Yexall/CPE-450.Capstone/README.md

# CPE-450.Capstone
Authors:
- Cameron Bracken
- Ryan Jacoby
- Noa Johnson
- Yexelle Nash Segovia
