Yexall/CPE-450.Capstone/Hardware/README.md

# Haas Hooligans Hardware

Board assembly prints and schematics for the final prototypes are provided in this directory. The three folders (IIS3DWB\_eval, IIS3DWB\_breakout\_beta, and hw\_alpha) have more detailed design sources for each of the PCBs designed.

## Main Board
Bringup notes and notes for the next revision of the main board can be found [here](https://github.com/Yexall/CPE-450.Capstone/blob/main/Hardware/hw_alpha/bringup_notes.md)

An interactive HTML BOM can be found [here](https://html-preview.github.io/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)

A downloadable PDF assembly document can be found [here](https://github.com/Yexall/CPE-450.Capstone/blob/main/Hardware/hw_alpha/plots/hw_alpha__Assembly.pdf)

A downloadable PDF schematic can be found [here](https://github.com/Yexall/CPE-450.Capstone/blob/main/Hardware/hw_alpha/hw_alpha_schem.pdf)

## IIS3DWB Breakout
A downloadable PDF assembly document can be found [here](https://github.com/Yexall/CPE-450.Capstone/blob/main/Hardware/IIS3DWB_breakout_beta/plots/IIS3DWB_breakout_beta__Assembly.pdf)

A downloadable PDF schematic can be found [here](https://github.com/Yexall/CPE-450.Capstone/blob/main/Hardware/IIS3DWB_breakout_beta/IIS3DWB_breakout_beta_schem.pdf)

## Copyright
Copyright Ryan Jacoby, Cal Poly CPE Department, Cal Poly IME Department 2025.

This source describes Open Hardware and is licensed under the CERN-OHL-P v2

You may redistribute and modify this documentation and make products
using it under the terms of the CERN-OHL-P v2 (https:/cern.ch/cern-ohl).
This documentation is distributed WITHOUT ANY EXPRESS OR IMPLIED
WARRANTY, INCLUDING OF MERCHANTABILITY, SATISFACTORY QUALITY
AND FITNESS FOR A PARTICULAR PURPOSE. Please see the CERN-OHL-P v2
for applicable conditions
