Yexall/CPE-450.Capstone/final_poster.pdf

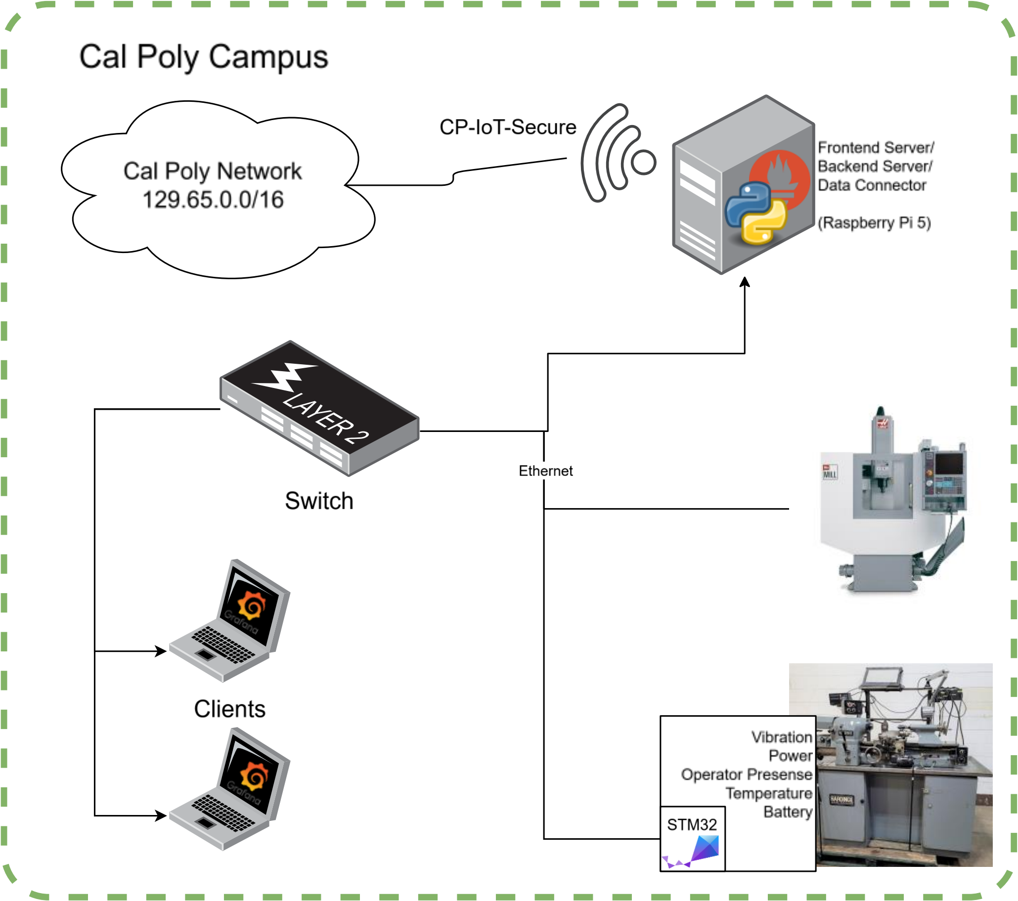
[picture p1: figure]
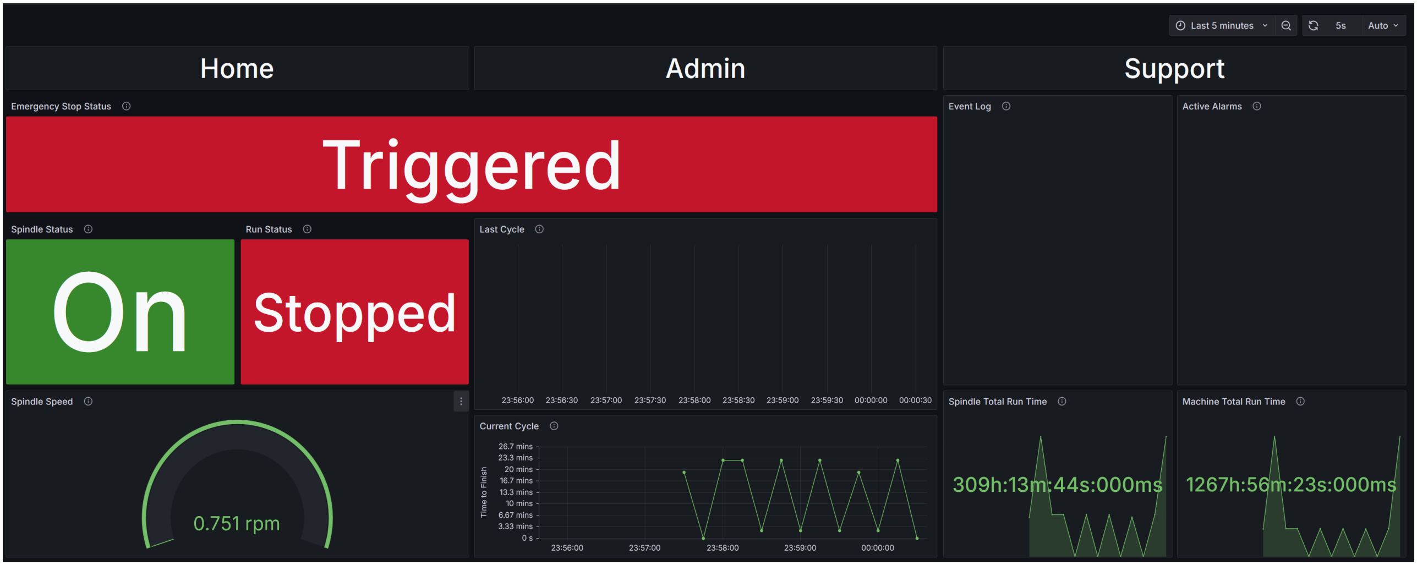
[picture p2: figure]

Power
Power can be provided through Ethernet (PoE), or USB-C through wall adapter or battery. The higher voltage supply will be voted through a PFET high-side switch to power 3.3 V regulator.
Sensing
The hardware includes vibration and temperature sensing using the IIS3DWB MEMS vibration sensor, held on a breakout board below the main PCB. Operator presence sensing can be done using a pre-made LD2401C breakout board. Connectivity
The hardware networks over Ethernet, WiFi, and could also log data over USB. An SD card is provided for offline logging. Older CNC machines can interface through the RS-232 port on the hardware. Further custom sensor boards to measure ways temperature, power consumption, or other metrics can easily be added through the two I2C expansion ports.

Sensor
Sensor data is collected via the STM32 running Zephyr RTOS over SPI from the II3WDWB sensor and currently outputting to the onboard UART terminal.

Dashboard
The dashboard collects data from the Haas machines and stores it in the Prometheus data base and visualized on the Grafana dashboard.

Purpose
The primary purpose of our project is to establish a robust, permanent digital infrastructure within the IME lab that enables real-time monitoring of machine tools. This infrastructure is designed to enhance operational efficiency, improve safety, and support proactive maintenance by providing instantaneous access to critical performance data.

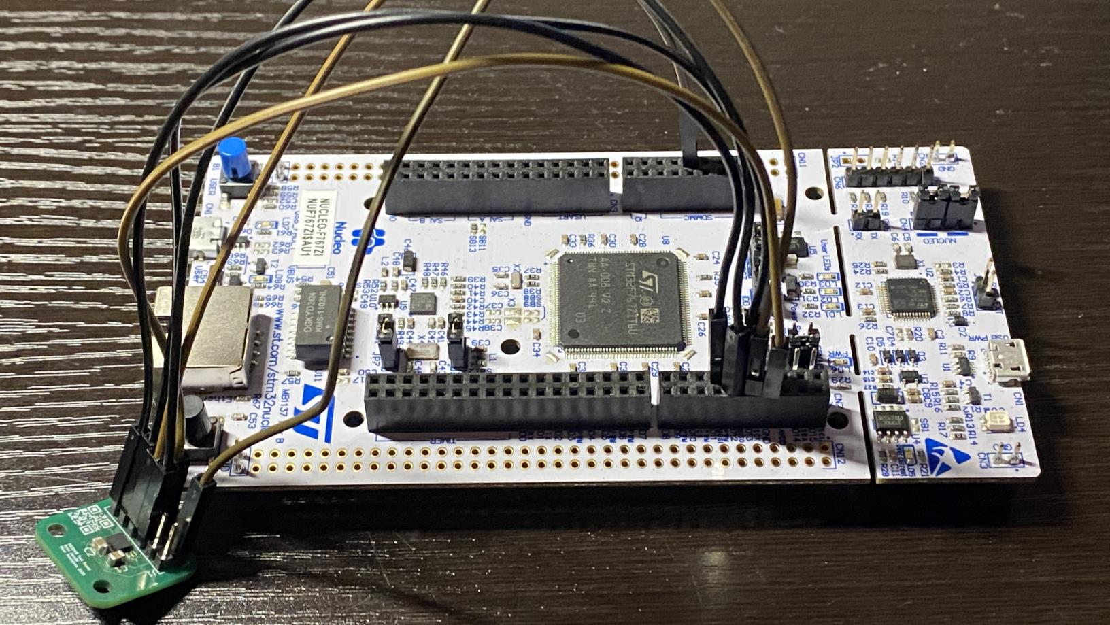
[picture p3: figure]
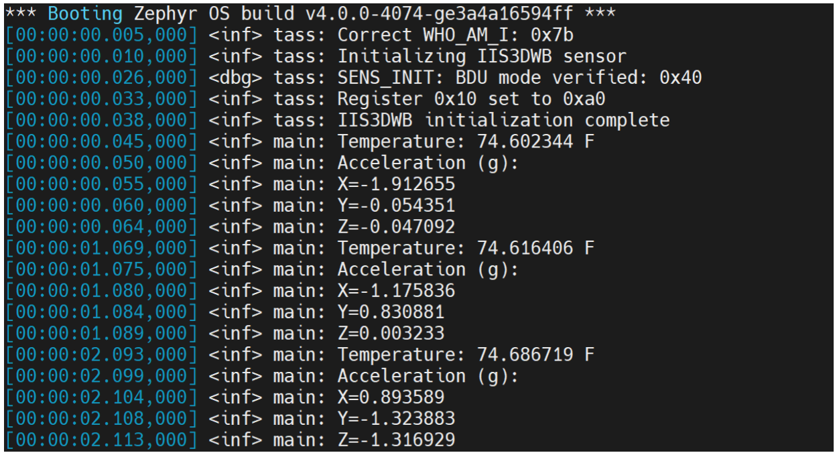
[picture p4: figure]

Objectives
- Sensor Integration
- Data Transmission & Processing
- User Interface Development
- Scalability & Future-proofing

## Project Overview

# MACHINE MONITORING IN THE IME LAB

COMPUTER ENGINEERING CAPSTONE 2025

## Requirements

Value to Customer | Description
Enable real-time monitoring of machine status and performance metrics | Remotely accessible, graphical representation of lab room
Infrastructure is thoroughly documented and designed for long-term sustainability | Develop an infrastructure plan to ensure long-term maintainability of the project
Provide enhanced visibility in non-networked, older machines | Custom hardware devices for capturing and transmitting sensor data
New machines are added to the infrastructure as they are acquired | Easily expandable to new hardware

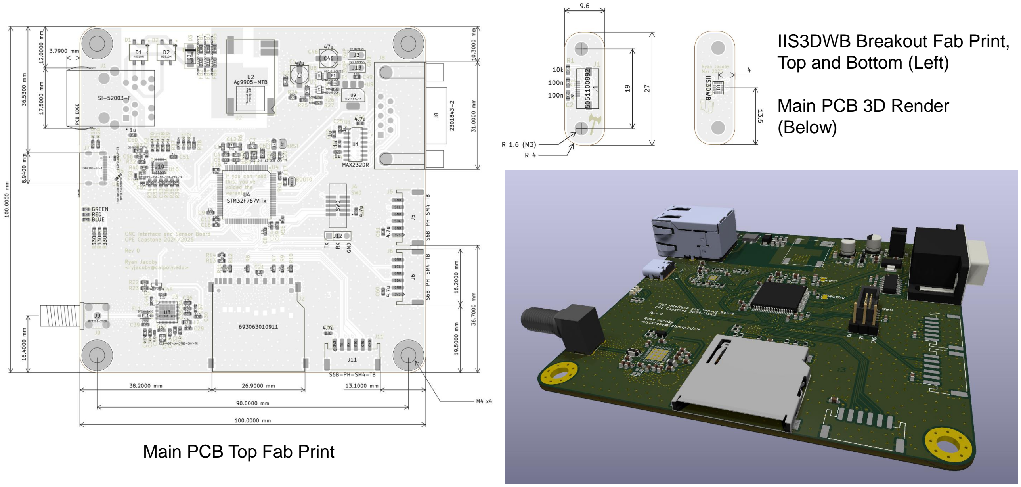
[picture p5: figure]
Main PCB Top Fab Print; IIS3DWB Breakout Fab Print, Top and Bottom (Left); Main PCB 3D Render (Below)

## Project/Product Results

## Demonstrated innovative, hands-on solutions to real-world

challenges at Cal Poly San Luis Obispo.

## Team

## Ryan Jacoby Nash Segovia Cameron Bracken Noa Johnson

## Client

## Dan Waldorf

Cal Poly IME Dept.

## Hardware Design

## System Architecture

## Sensor-to-Dashboard Integration

## Verification Plans

Specification | Description
Data Collection Timing | Run firmware under simulated operational conditions. Log sampling intervals and compare against nominal values.
Error Handling | Inject various error conditions and monitor the firmware’s logging and exception handling mechanisms.
Data Visualization | Query large quantities of data. Check for freeing or outdated information.
Concurrent Users | Have multiple users access the website at the same time. Monitor the performance and stability during heavy loads.

## Learnings and Future Work

Learnings:
- Researching of certain systems during firmware development took a long time
- During PCB design research of standards and components was a significant time strain.
Future Work:
- Testing of firmware and hardware integration
- Testing of firmware and Grafana/Prometheus integration
