Yexall/CPE-450.Capstone/Hardware/hw_alpha/stm32_pinout.png

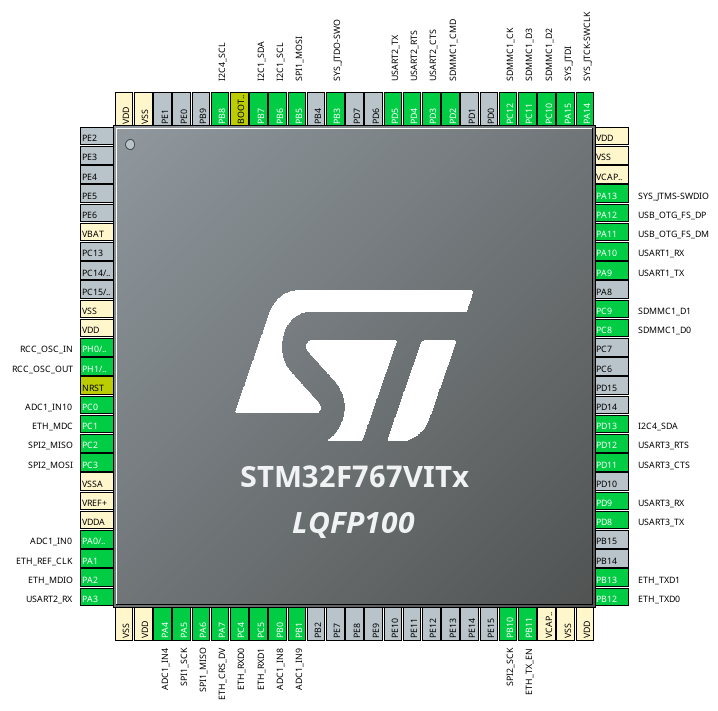
Hardware/hw_alpha/stm32_pinout.png
