Yexall/CPE-450.Capstone/Hardware/hw_alpha/3D/Wurth-693063010911.stp

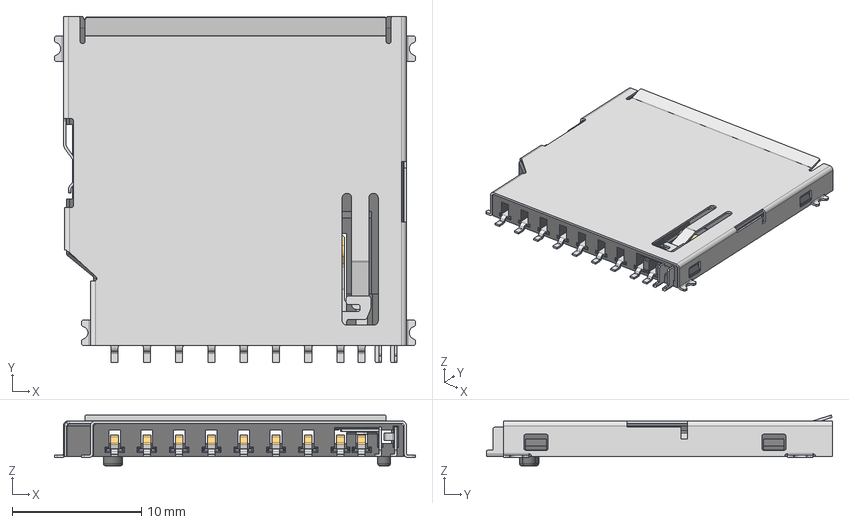
[picture p7: CAD file, 2025-03-19]
Hardware/hw_alpha/3D/Wurth-693063010911.stp
28.0 x 26.8 x 3.95 mm
693063010911_Housing
693063010911_PIN_CONTACT
693063010911_PIN_RETENTION
693063010911_PIN_P x 5
693063010911_PIN_M
693063010911_PIN_G x 2
693063010911_PIN_TG
693063010911_Shielding
