Yexall/CPE-450.Capstone/Hardware/hw_alpha/3D/USB4105-GF-A.step

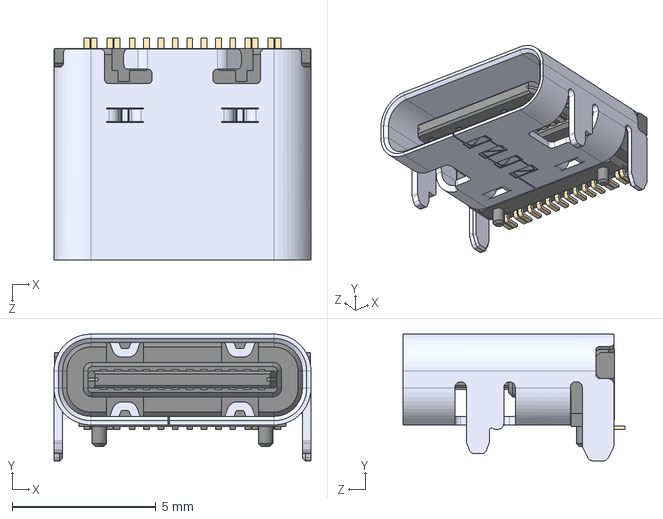
[picture p8: CAD file, 2025-03-19]
Hardware/hw_alpha/3D/USB4105-GF-A.step
8.94 x 4.41 x 7.71 mm
