Yexall/CPE-450.Capstone/Hardware/hw_alpha/3D/3220-10-0300-00.step

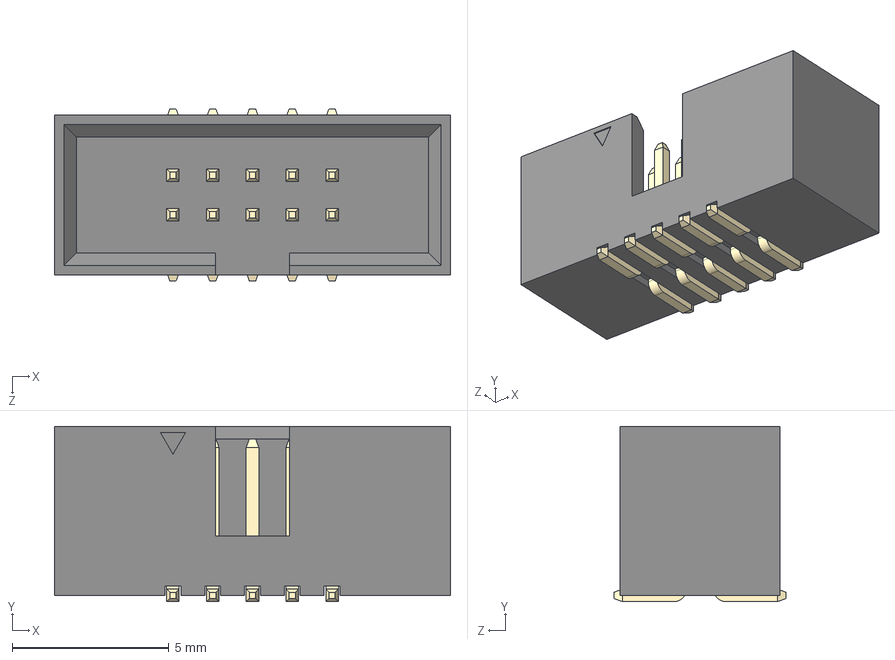
[picture p9: CAD file, 2025-03-19]
Hardware/hw_alpha/3D/3220-10-0300-00.step
12.7 x 5.60 x 5.50 mm
3220-xx-0300-00 body_10
Pin^3220-xx-0300-00 x 5
MirrorPin^3220-xx-0300-00 x 5
