Yexall/CPE-450.Capstone/Hardware/hw_alpha/3D/SI-52003-F.step

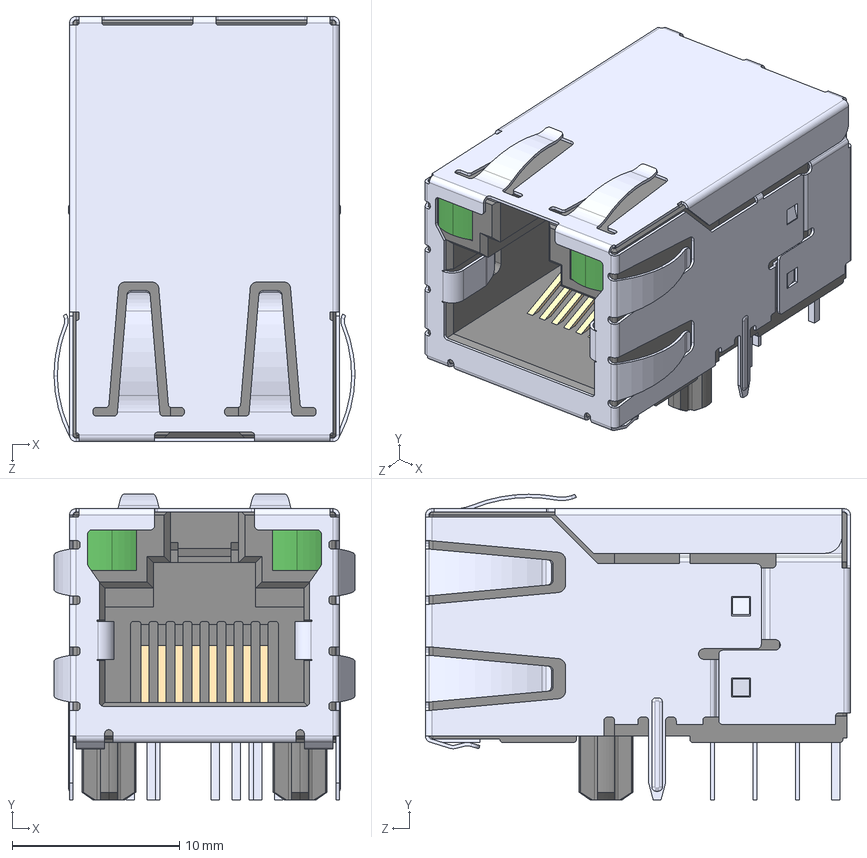
[picture p10: CAD file, 2025-03-19]
Hardware/hw_alpha/3D/SI-52003-F.step
18.0 x 18.3 x 25.4 mm
