Yexall/CPE-450.Capstone/Hardware/hw_alpha/3D/c-2301843-2-b1-3d.stp

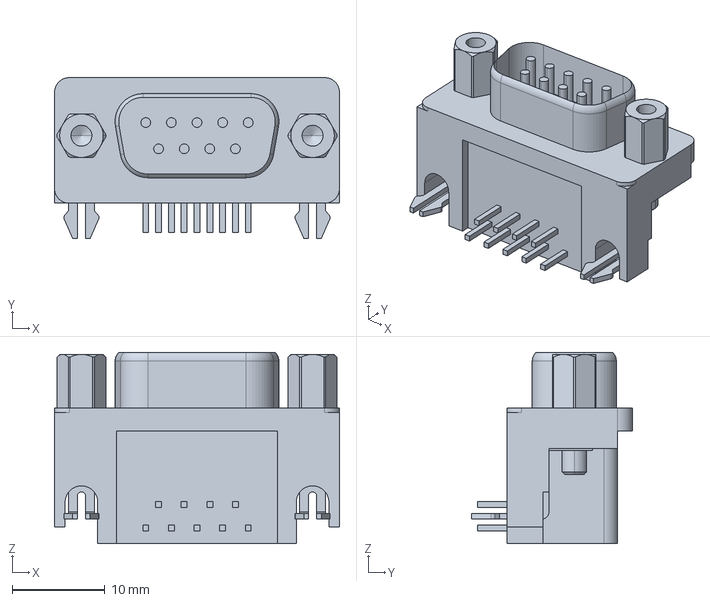
[picture p11: CAD file, 2025-03-19]
Hardware/hw_alpha/3D/c-2301843-2-b1-3d.stp
30.8 x 17.4 x 20.6 mm
