Yexall/CPE-450.Capstone/Hardware/hw_alpha/3D/HDS_DIO.step

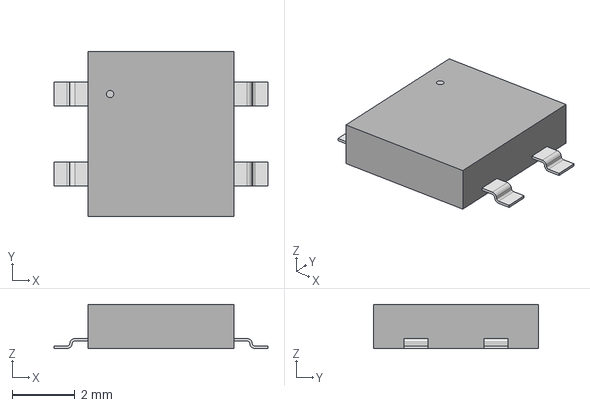
[picture p12: CAD file, 2025-03-19]
Hardware/hw_alpha/3D/HDS_DIO.step
6.81 x 5.26 x 1.40 mm
