Yexall/CPE-450.Capstone/Hardware/IIS3DWB_breakout_beta/3D/5051100892.stp

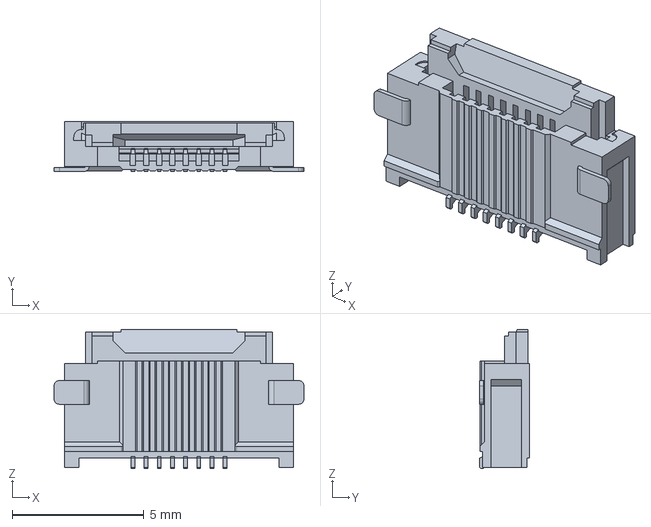
[picture p13: CAD file, 2025-03-19]
Hardware/IIS3DWB_breakout_beta/3D/5051100892.stp
9.50 x 1.90 x 5.30 mm
