Yexall/CPE-450.Capstone/Hardware/hw_alpha/hw_alpha_schem.pdf

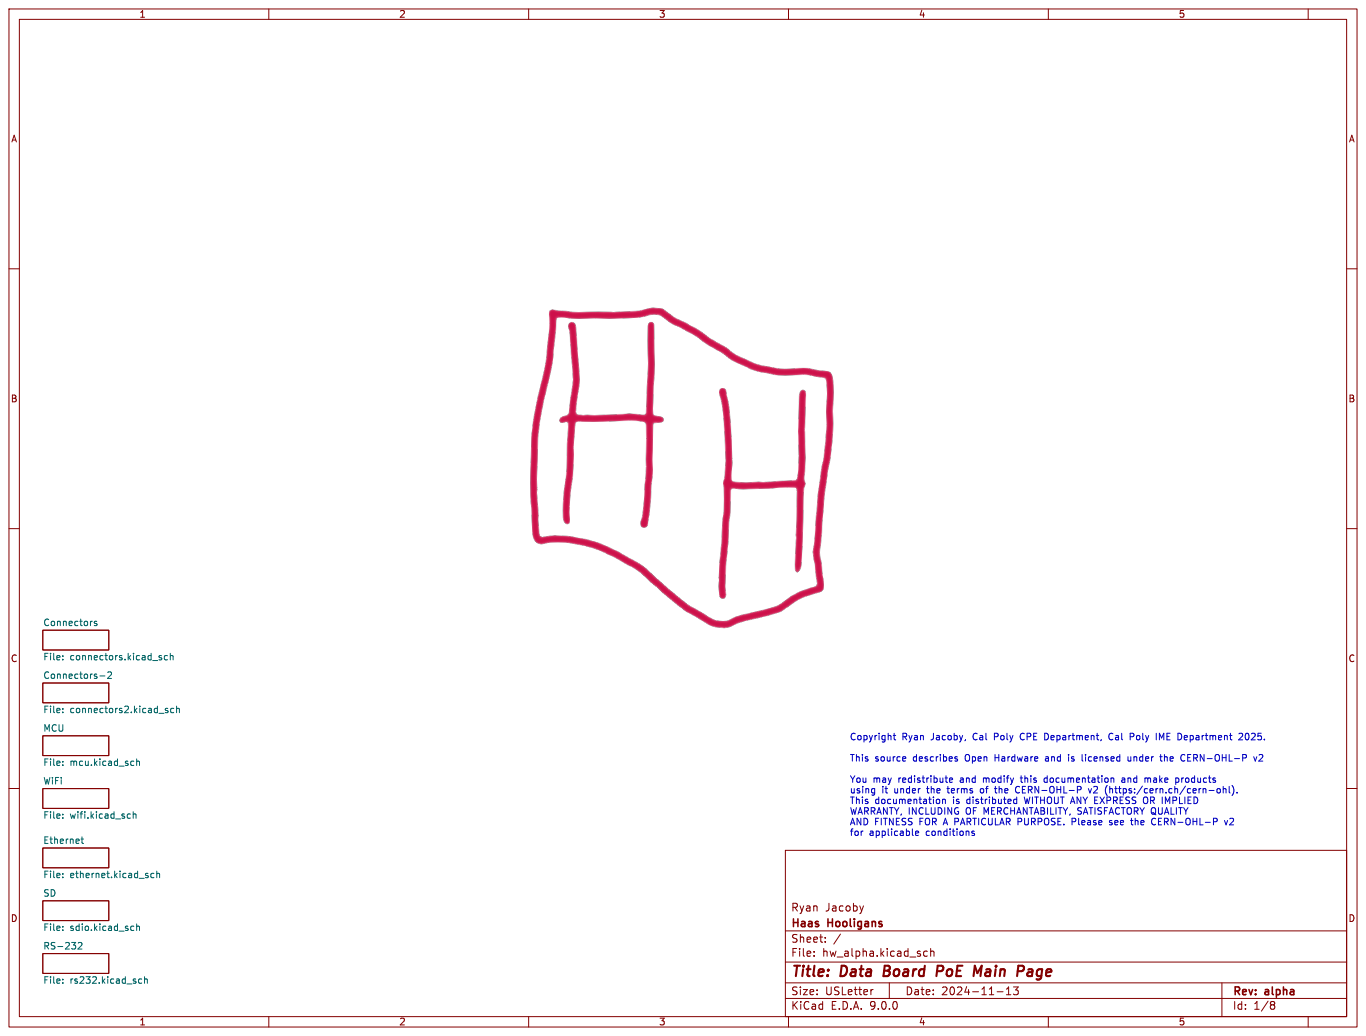
[picture p15: page 1]

Ryan Jacoby Connectors File: connectors.kicad_sch RS-232 File: rs232.kicad_sch Connectors-2 File: connectors2.kicad_sch Ethernet File: ethernet.kicad_sch SD
File: sdio.kicad_sch MCU

Id: 1/8 Title: Data Board PoE Main Page

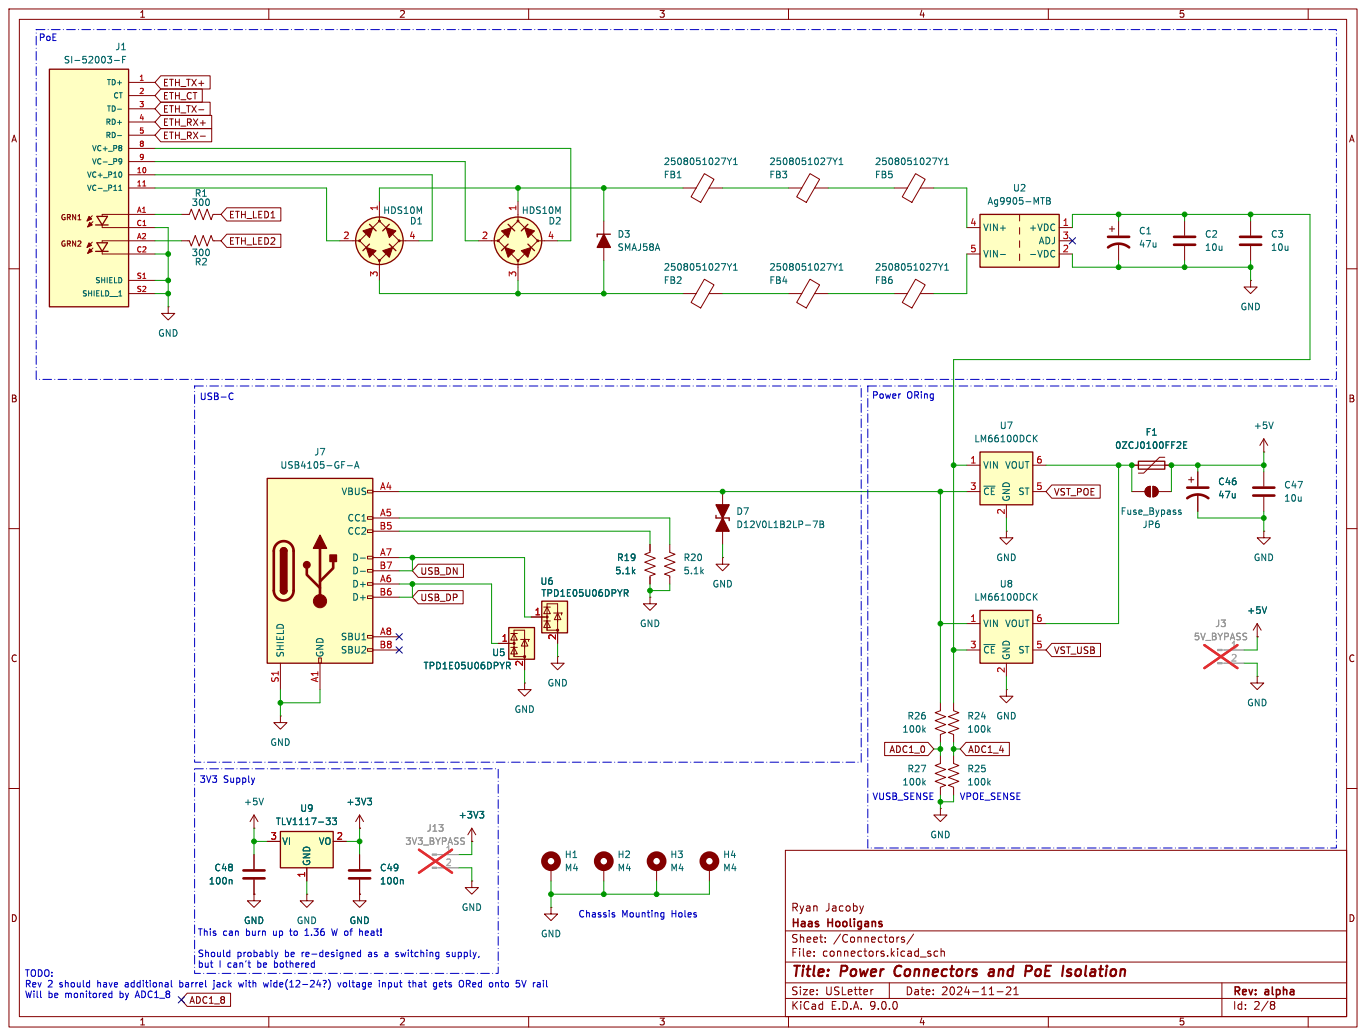
[picture p16: page 2]

Id: 2/8 Title: Power Connectors and PoE Isolation

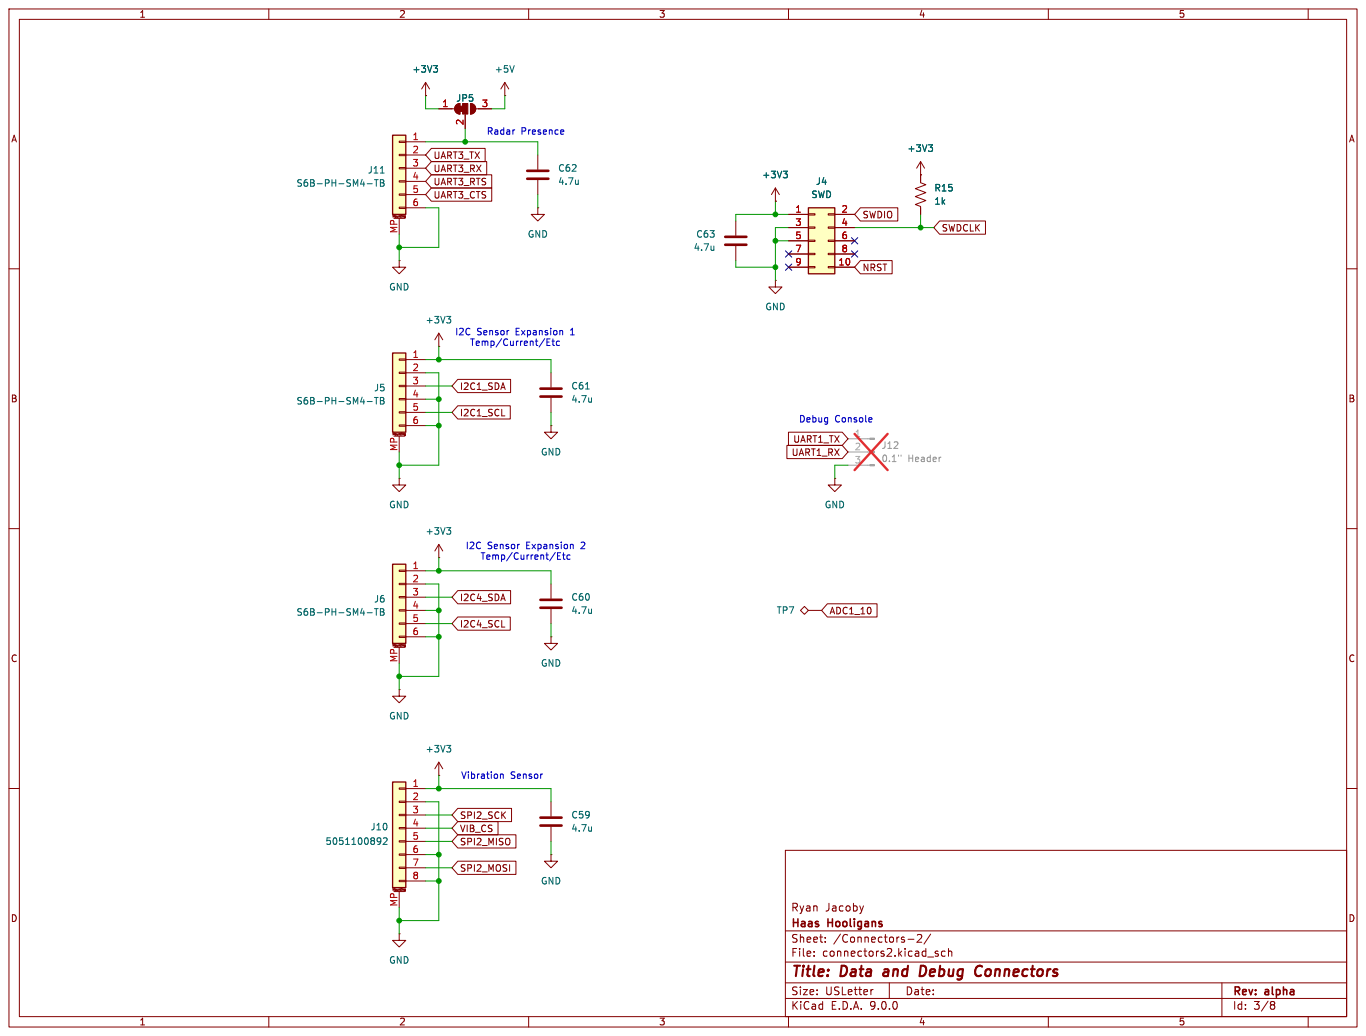
[picture p17: page 3]

I2C Sensor Expansion 1 Temp/Current/Etc
I2C1_SCL SPI2_MOSI SPI2_SCK

Id: 3/8 Title: Data and Debug Connectors

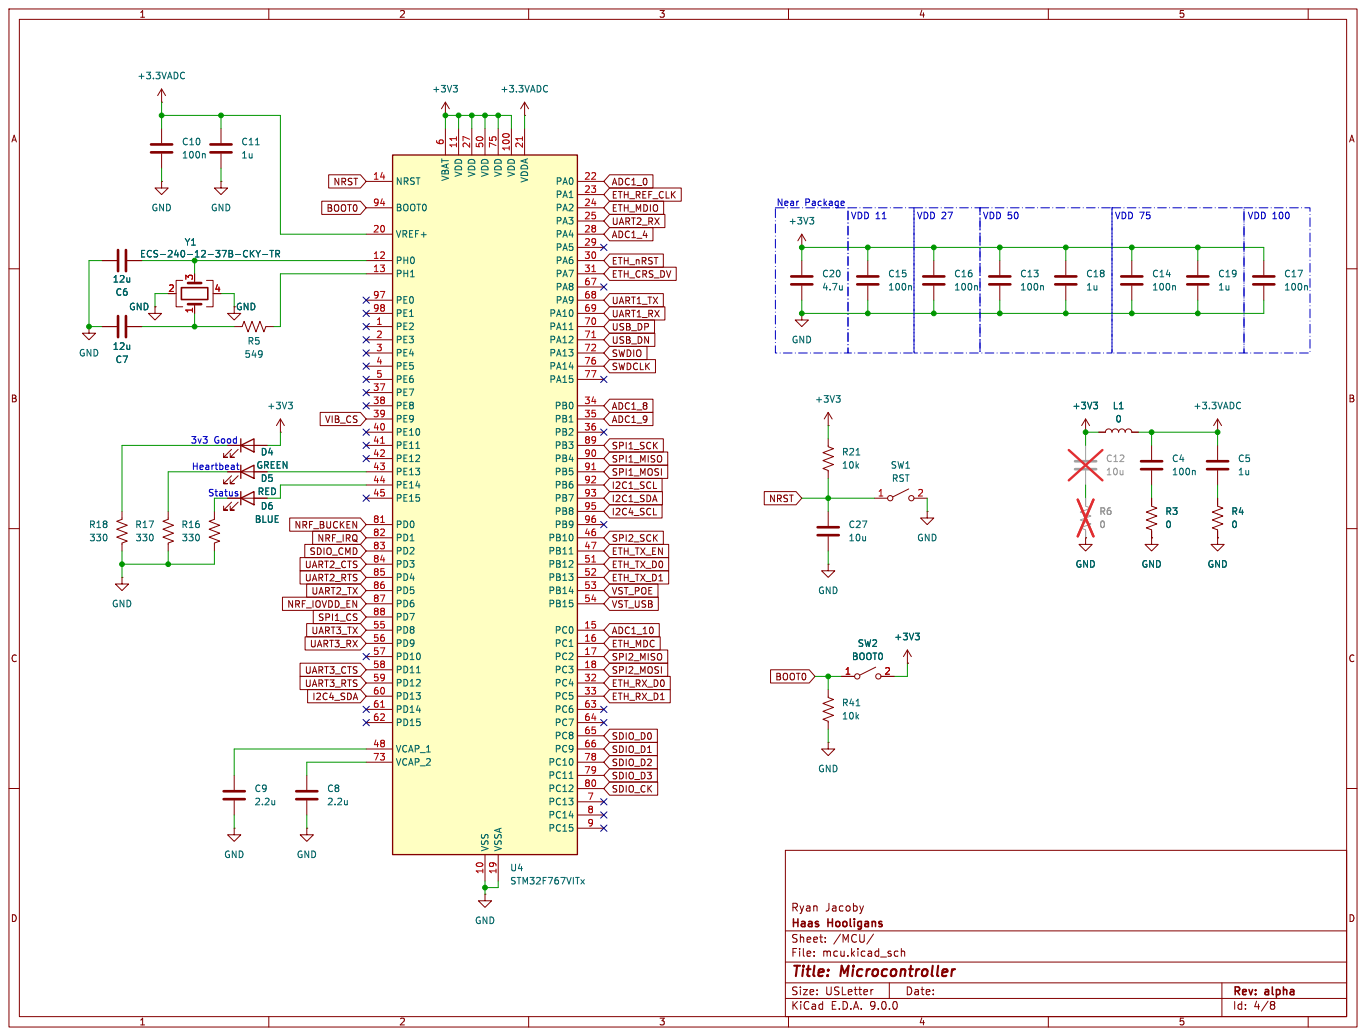
[picture p18: page 4]

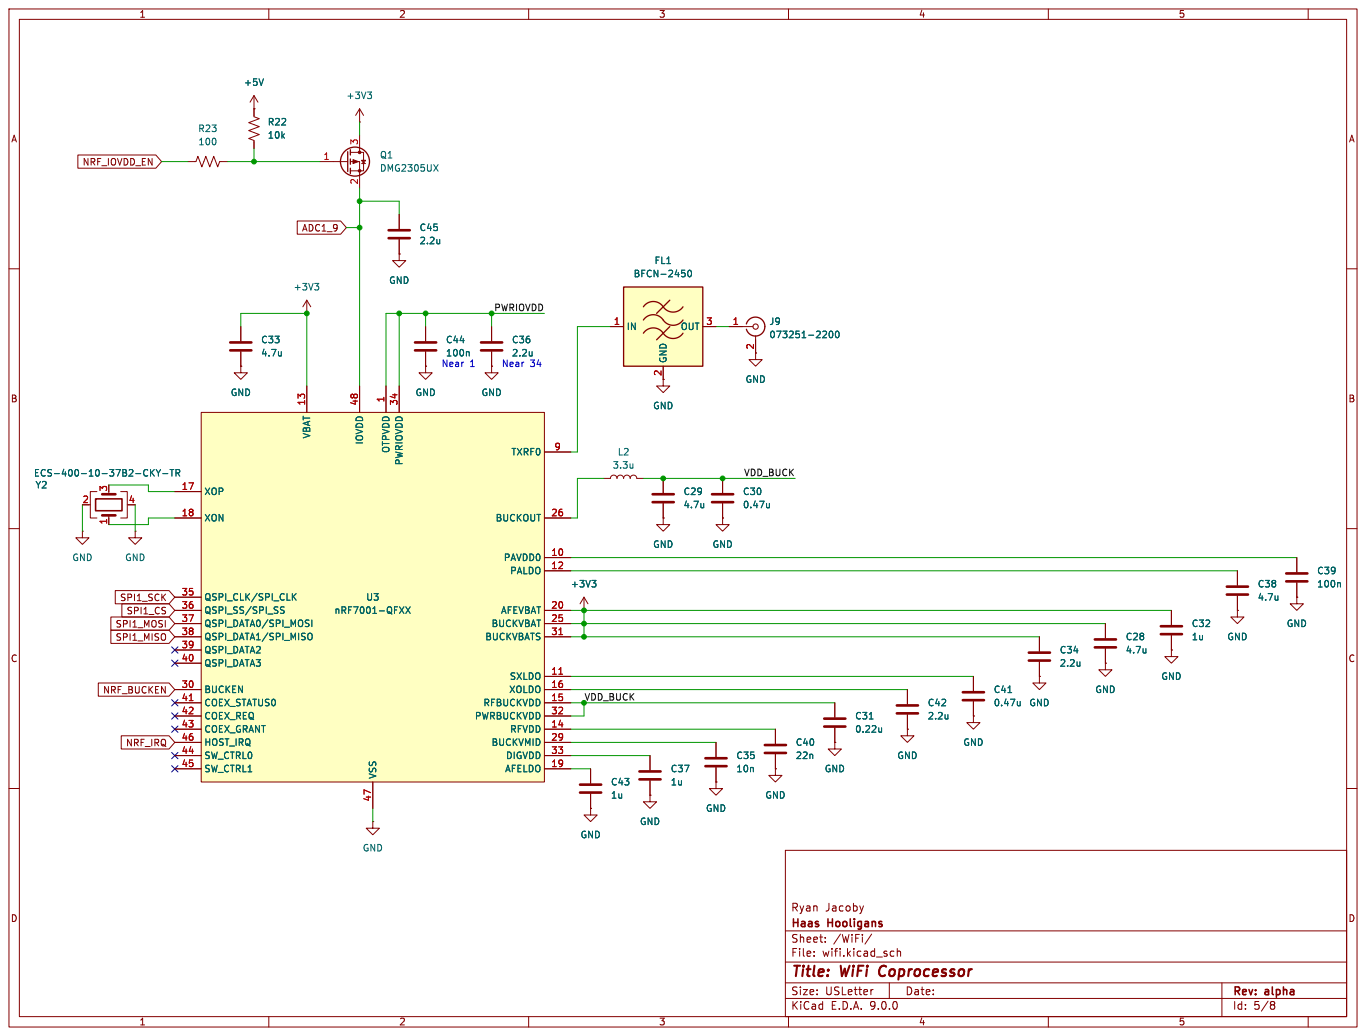
[picture p19: page 5]

1 PWRIOVDD 34 TXRF0 9 BUCKOUT 26 PAVDD0 10 PALDO 12 AFEVBAT 20 BUCKVBAT 25 BUCKVBATS 31 SXLDO 11 XOLDO 16 RFBUCKVDD 15 PWRBUCKVDD 32 RFVDD 14 BUCKVMID 29 DIGVDD 33 AFELDO 19 QSPI_CLK/SPI_CLK 35 VSS 47 Y2 ECS-400-10-37B2-CKY-TR

1 PWRIOVDD 34 TXRF0 9 BUCKOUT 26 PAVDD0 10 PALDO 12 AFEVBAT 20 BUCKVBAT 25 BUCKVBATS 31 SXLDO 11 XOLDO 16 RFBUCKVDD 15 PWRBUCKVDD 32 RFVDD 14 BUCKVMID 29 DIGVDD 33 AFELDO 19 QSPI_CLK/SPI_CLK 35 VSS 47 U3

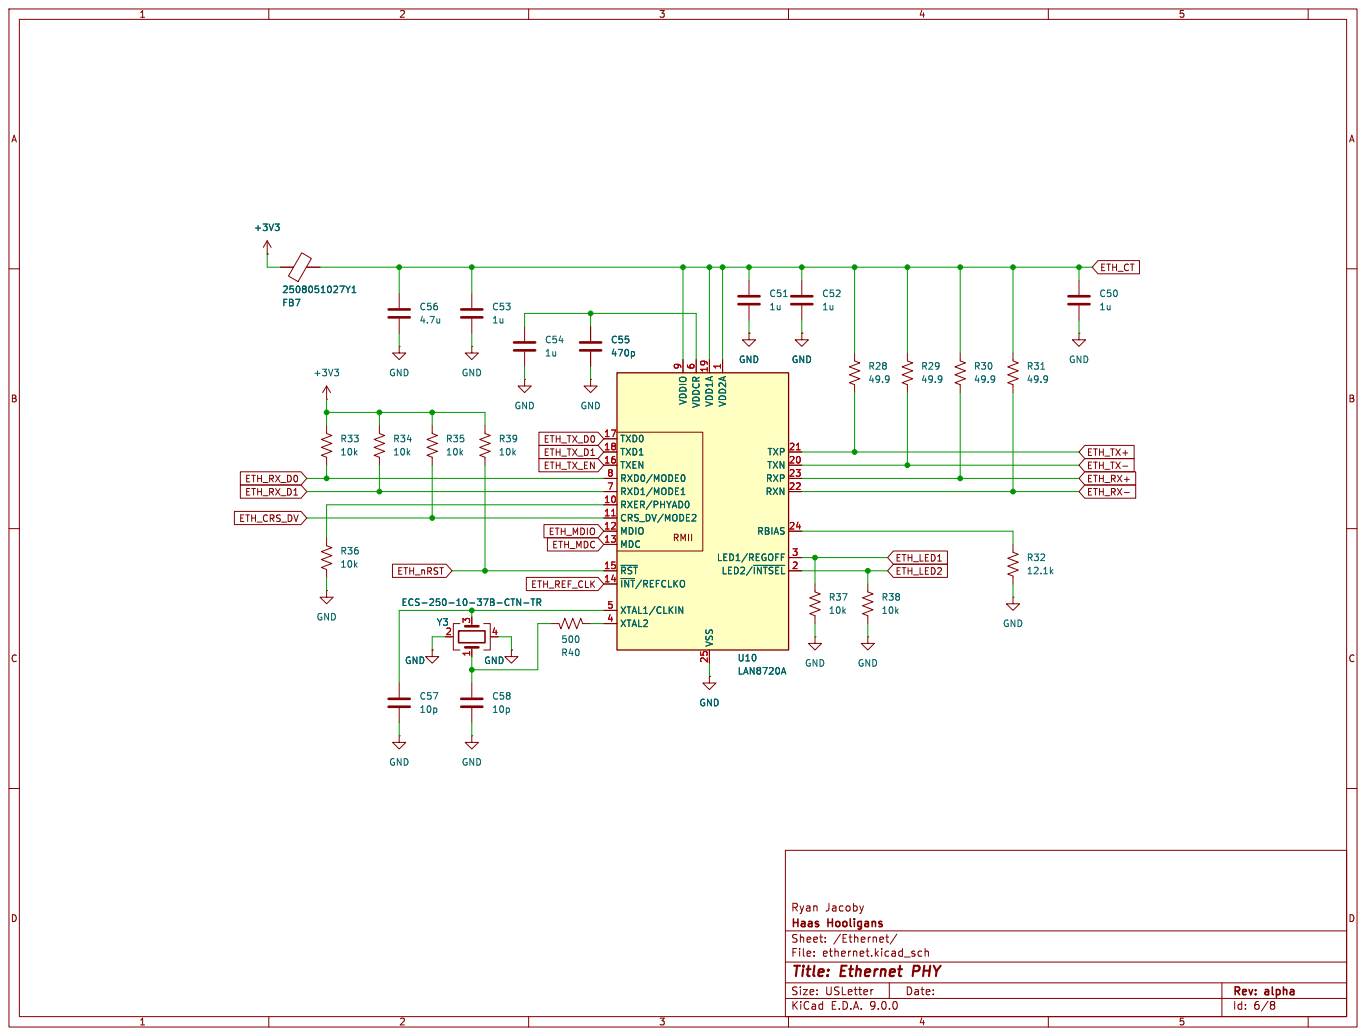
[picture p20: page 6]

1 TXP 21 TXN 20 RXP 23 RXN 22 RBIAS 24

Id: 6/8 Title: Ethernet PHY

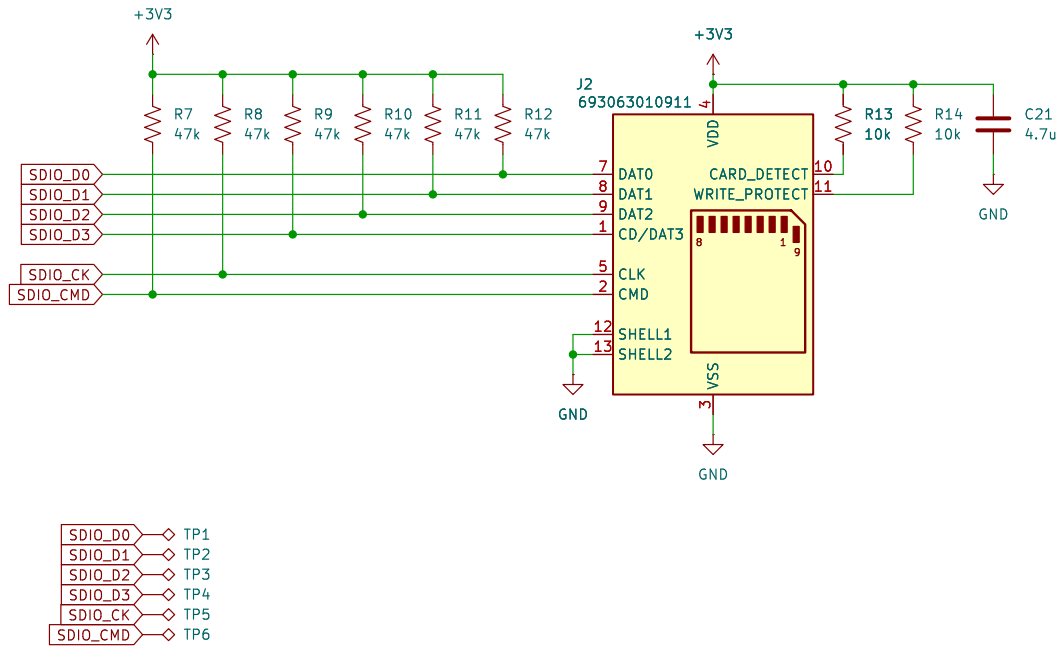
[picture p21: page 7]

Id: 7/8 Title: SD Card

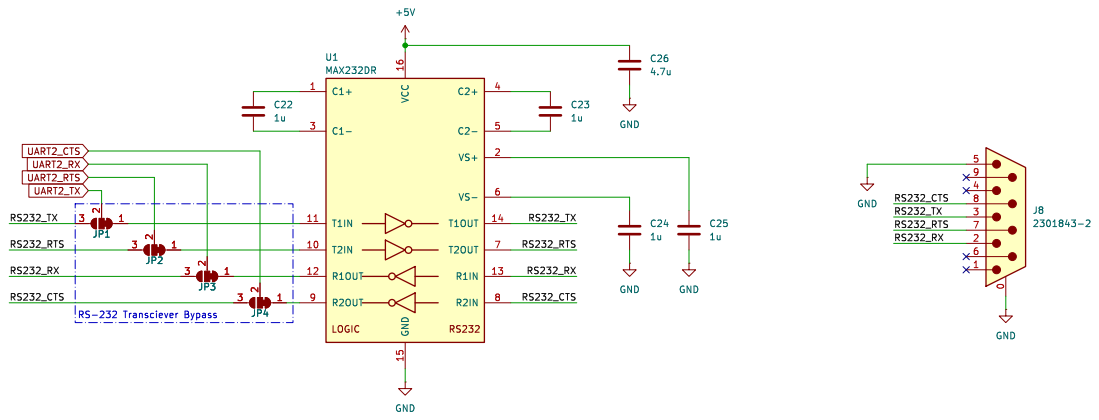
[picture p22: page 8]
