Yexall/CPE-450.Capstone/Hardware/IIS3DWB_breakout_beta/IIS3DWB_breakout_beta_schem.pdf

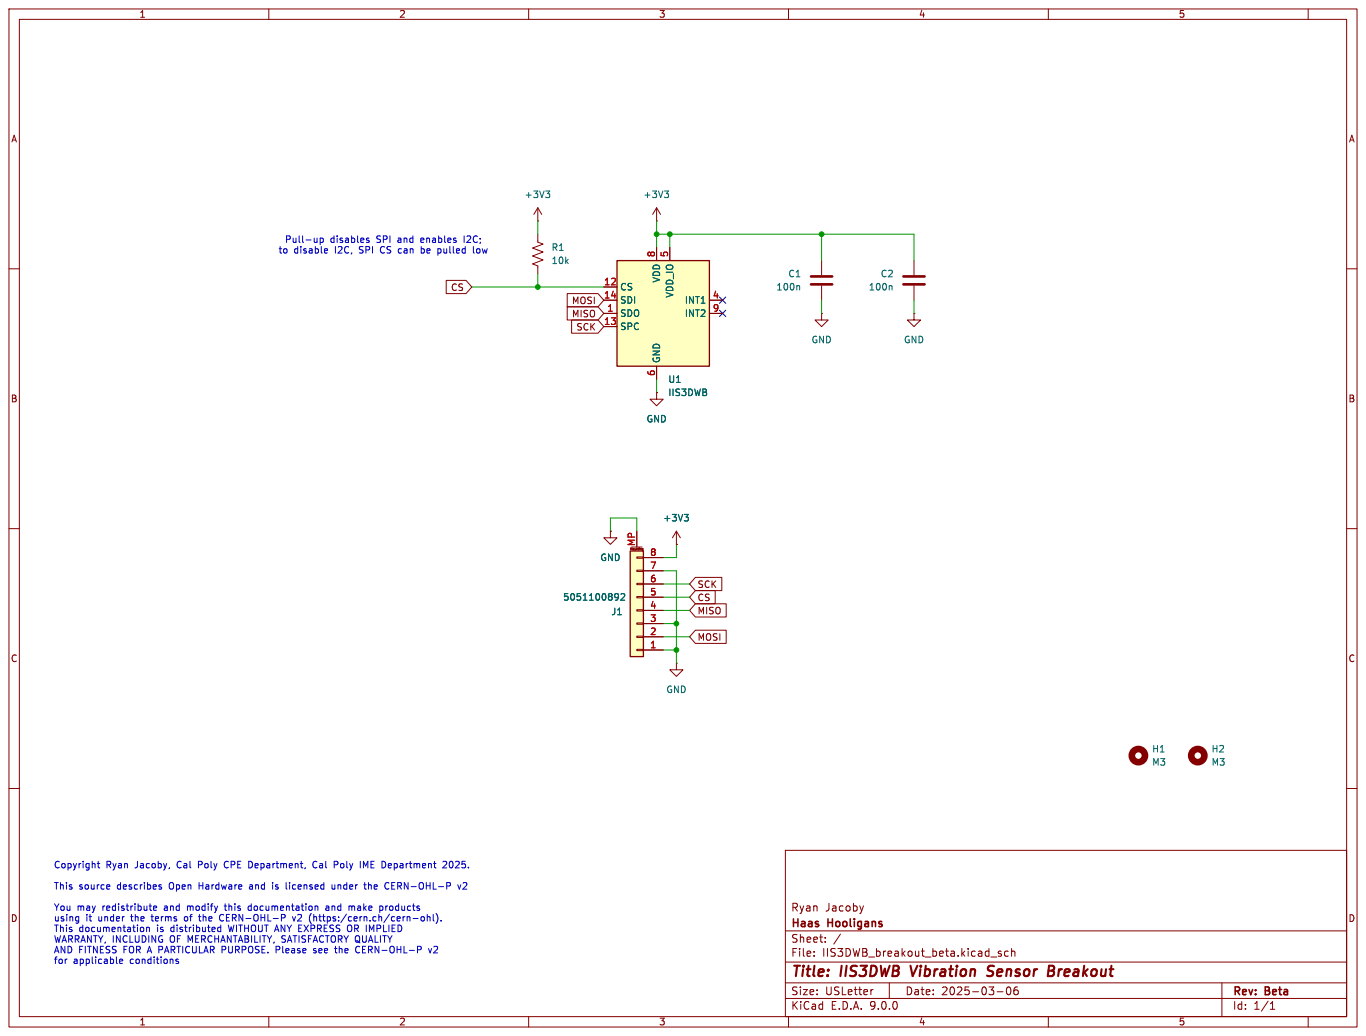
[picture p23: page 1]

to disable I2C, SPI CS can be pulled low
