Yexall/CPE-450.Capstone/Hardware/hw_alpha/hw_alpha_prelayout_schem.pdf

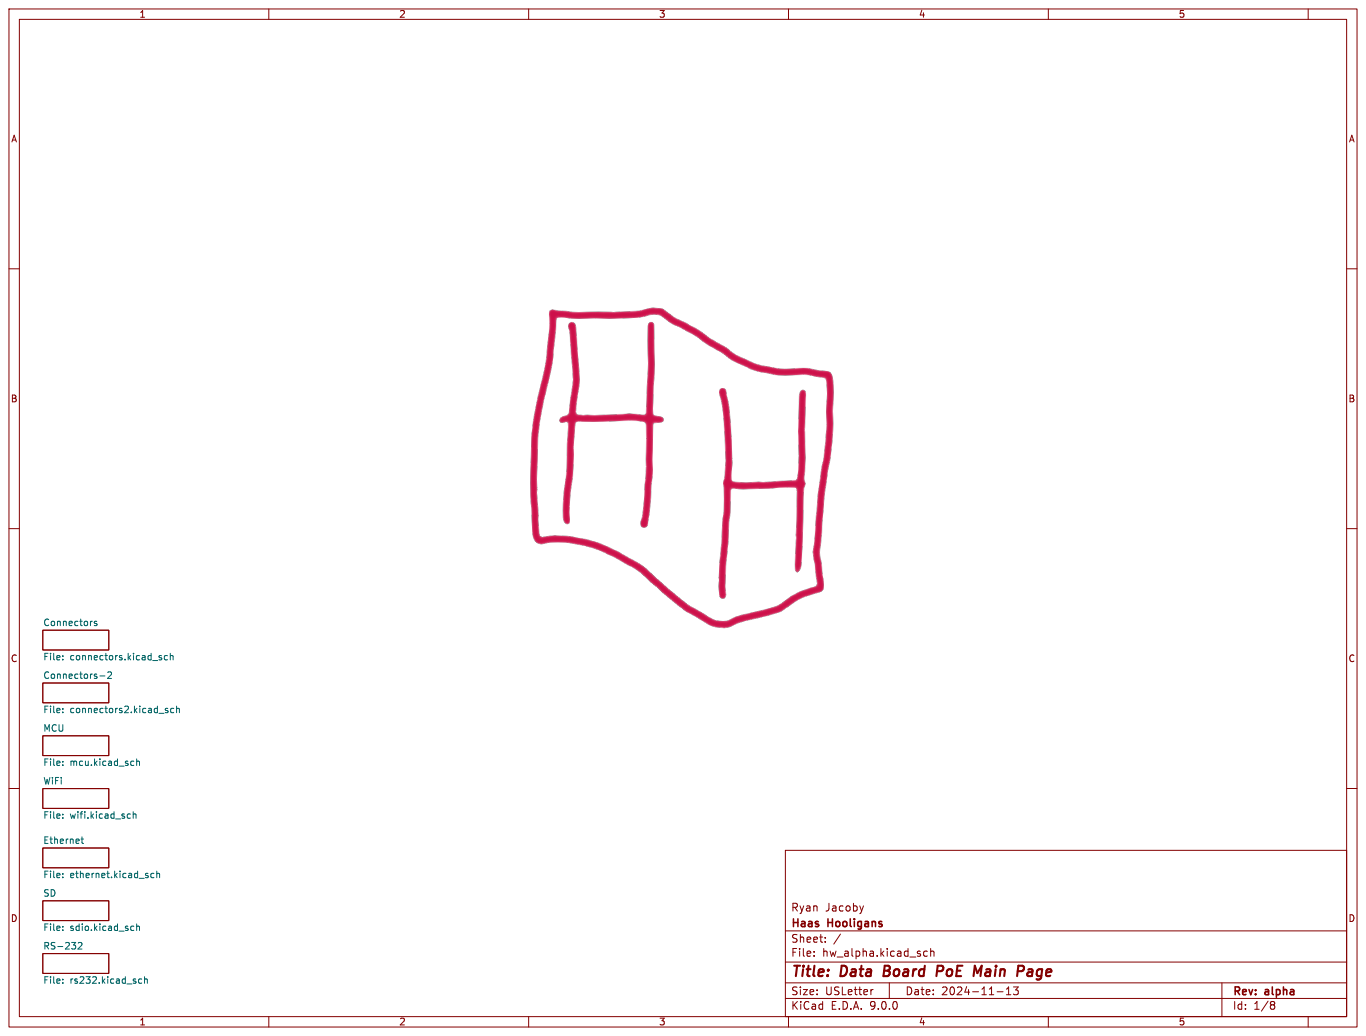
[picture p24: page 1]

Ryan Jacoby Connectors File: connectors.kicad_sch RS-232 File: rs232.kicad_sch WiFi File: wifi.kicad_sch Connectors-2 File: connectors2.kicad_sch MCU

File: mcu.kicad_sch Ethernet File: ethernet.kicad_sch SD

Id: 1/8 Title: Data Board PoE Main Page

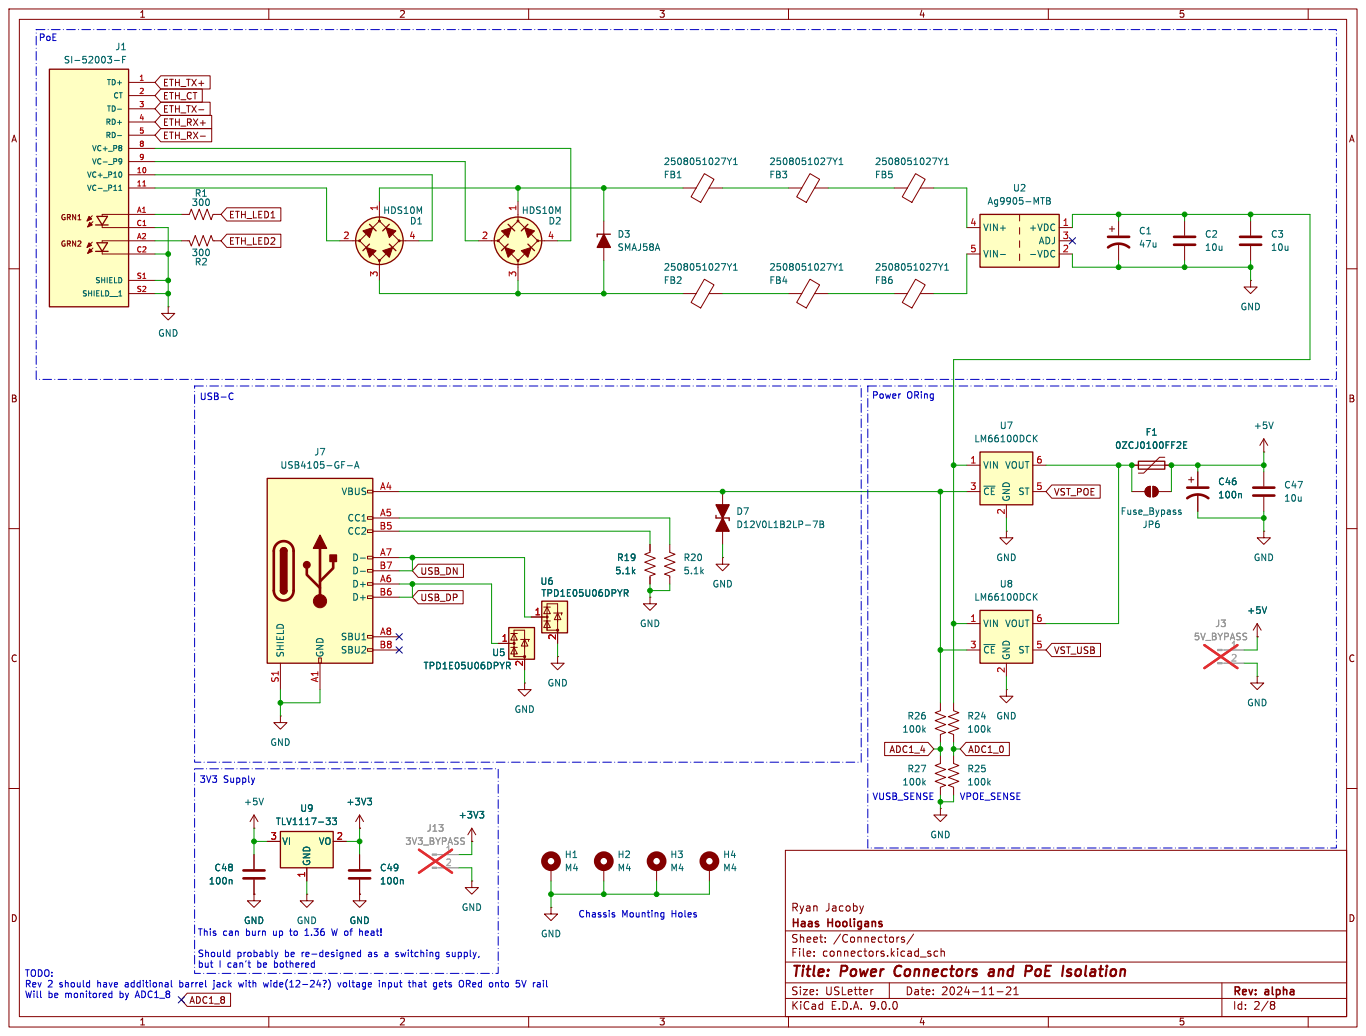
[picture p25: page 2]

2 U5 TPD1E05U06DPYR GND SHIELD S1 GND A1 VBUS A4 CC1 A5 CC2 B5 D- A7 D- B7 D+ A6 D+ B6 SBU1 A8 SBU2 B8

Id: 2/8 Title: Power Connectors and PoE Isolation

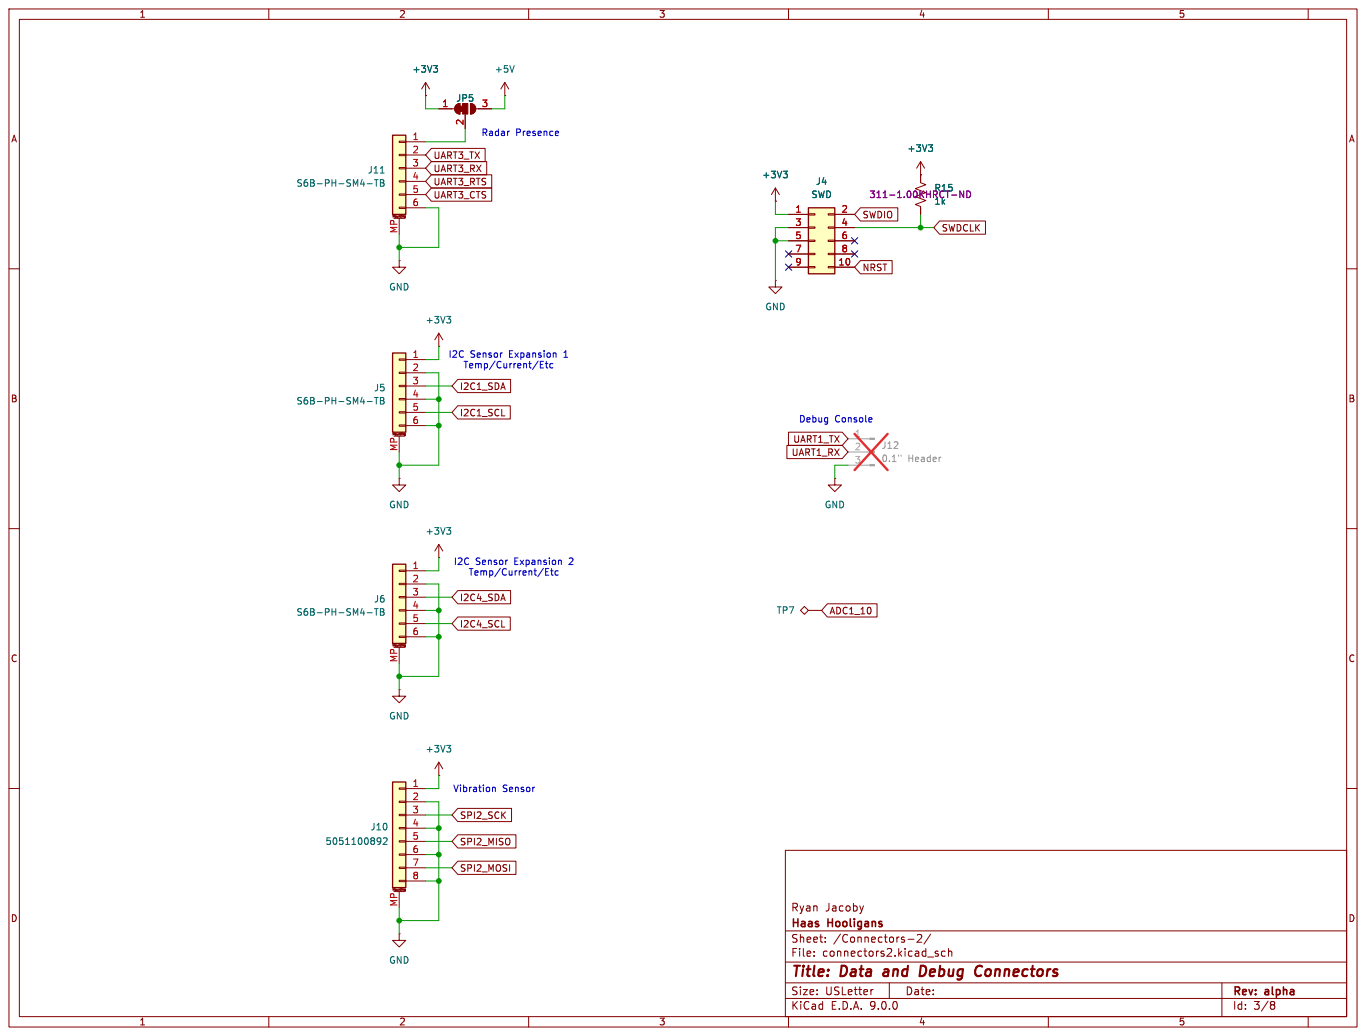
[picture p26: page 3]

I2C Sensor Expansion 1 Temp/Current/Etc Radar Presence

Id: 3/8 Title: Data and Debug Connectors

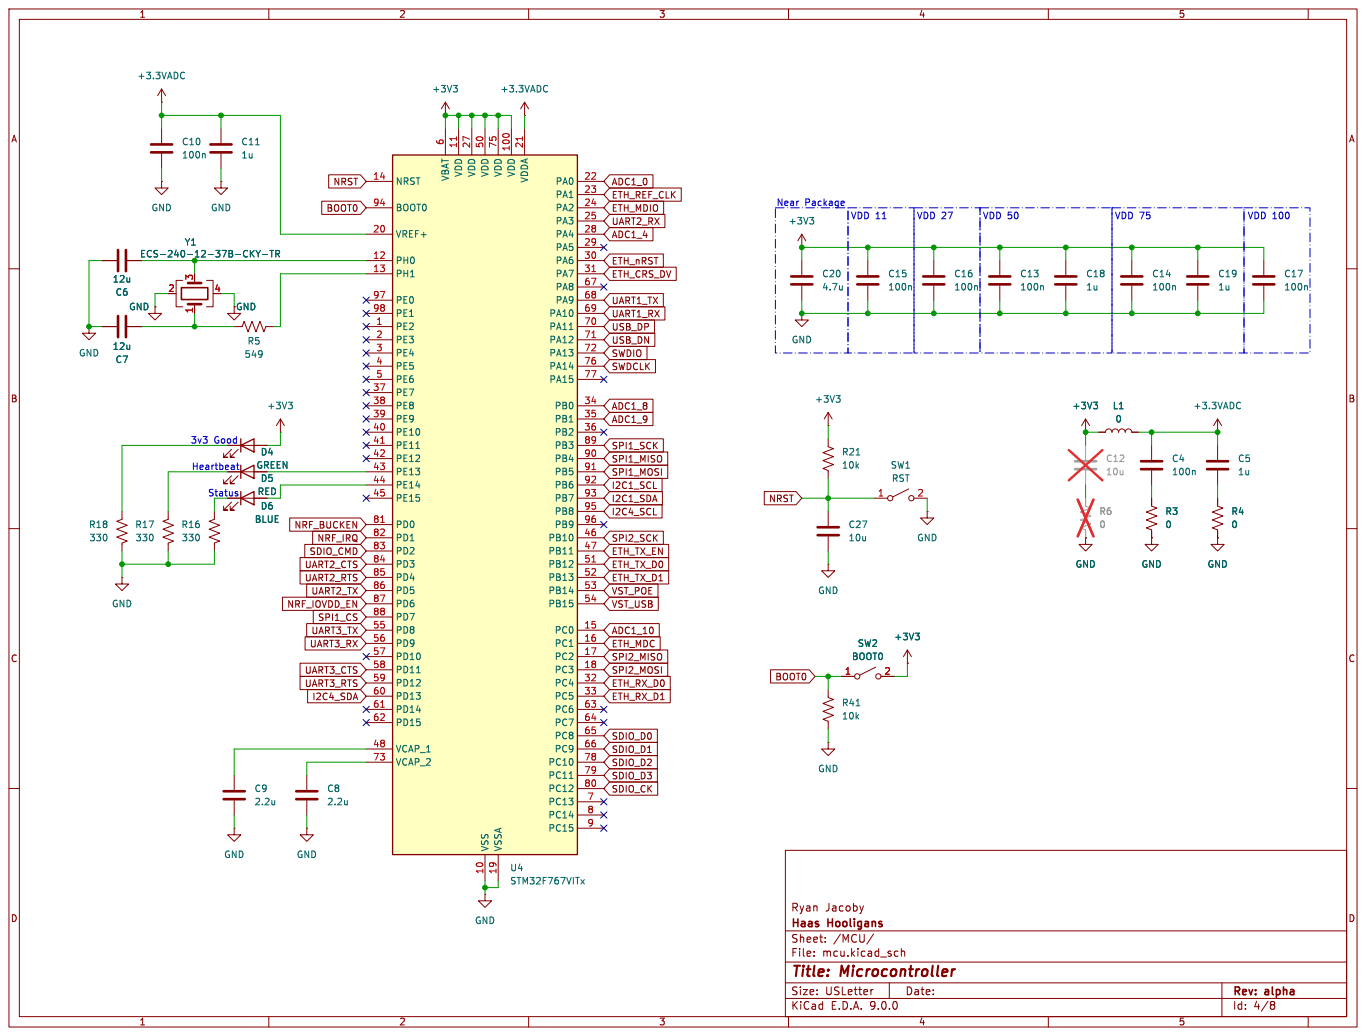
[picture p27: page 4]


1 PWRIOVDD 34 TXRF0 9 BUCKOUT 26 PAVDD0 10 PALDO 12 AFEVBAT 20 BUCKVBAT 25 BUCKVBATS 31 SXLDO 11 XOLDO 16 RFBUCKVDD 15 PWRBUCKVDD 32 RFVDD 14 BUCKVMID 29 DIGVDD 33 AFELDO 19 QSPI_CLK/SPI_CLK 35 VSS 47 Y2 ECS-400-10-37B2-CKY-TR

1 PWRIOVDD 34 TXRF0 9 BUCKOUT 26 PAVDD0 10 PALDO 12 AFEVBAT 20 BUCKVBAT 25 BUCKVBATS 31 SXLDO 11 XOLDO 16 RFBUCKVDD 15 PWRBUCKVDD 32 RFVDD 14 BUCKVMID 29 DIGVDD 33 AFELDO 19 QSPI_CLK/SPI_CLK 35 VSS 47 U3


1 TXP 21 TXN 20 RXP 23 RXN 22 RBIAS 24

Id: 6/8 Title: Ethernet PHY


Id: 7/8 Title: SD Card
