Yexall/CPE-450.Capstone/Hardware/IIS3DWB_eval/IIS3DWB_eval.pdf

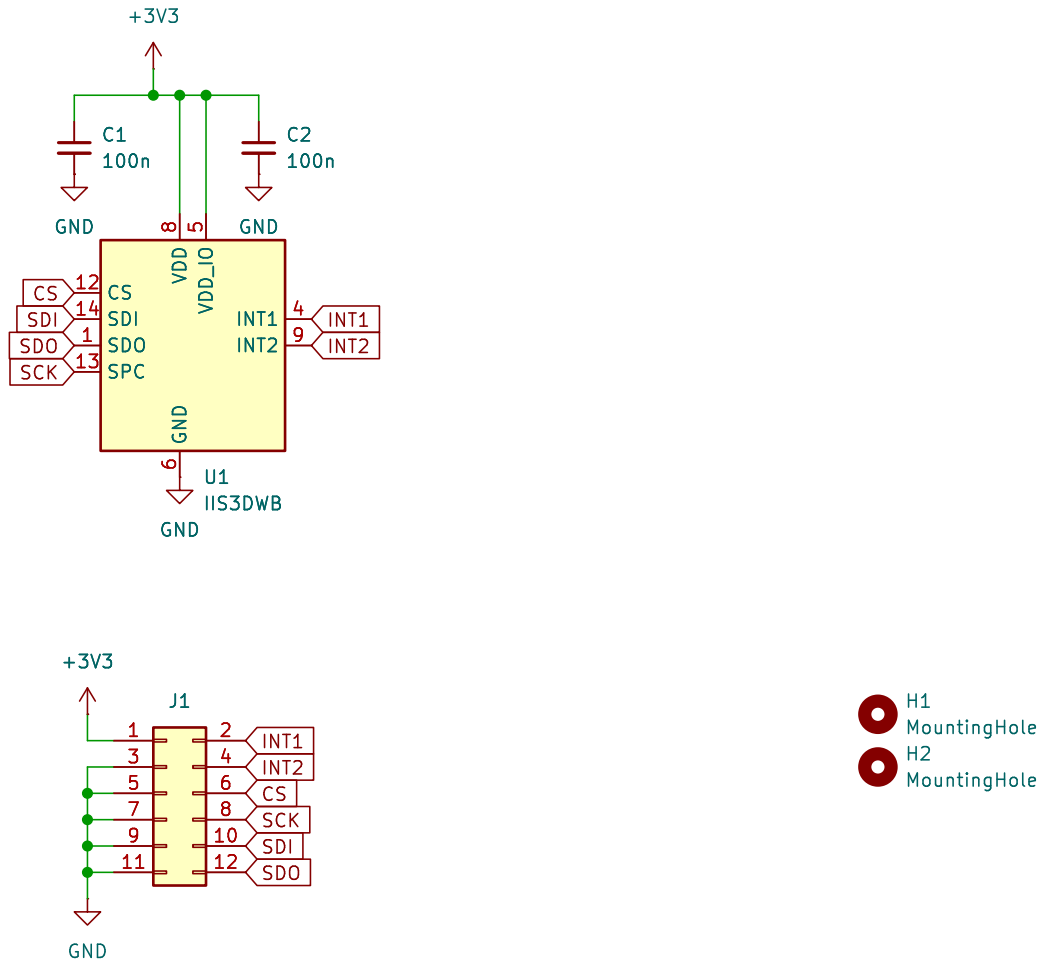
[picture p28: page 1]

Id: 1/1 Title: IIS3DWB Eval board
