Yexall/CPE-450.Capstone/Hardware/hw_alpha/plots/hw_alpha__Assembly.pdf

# BOOT0 SWD ³V³P ⁵VP

# C26 3V3_BYPASS J13

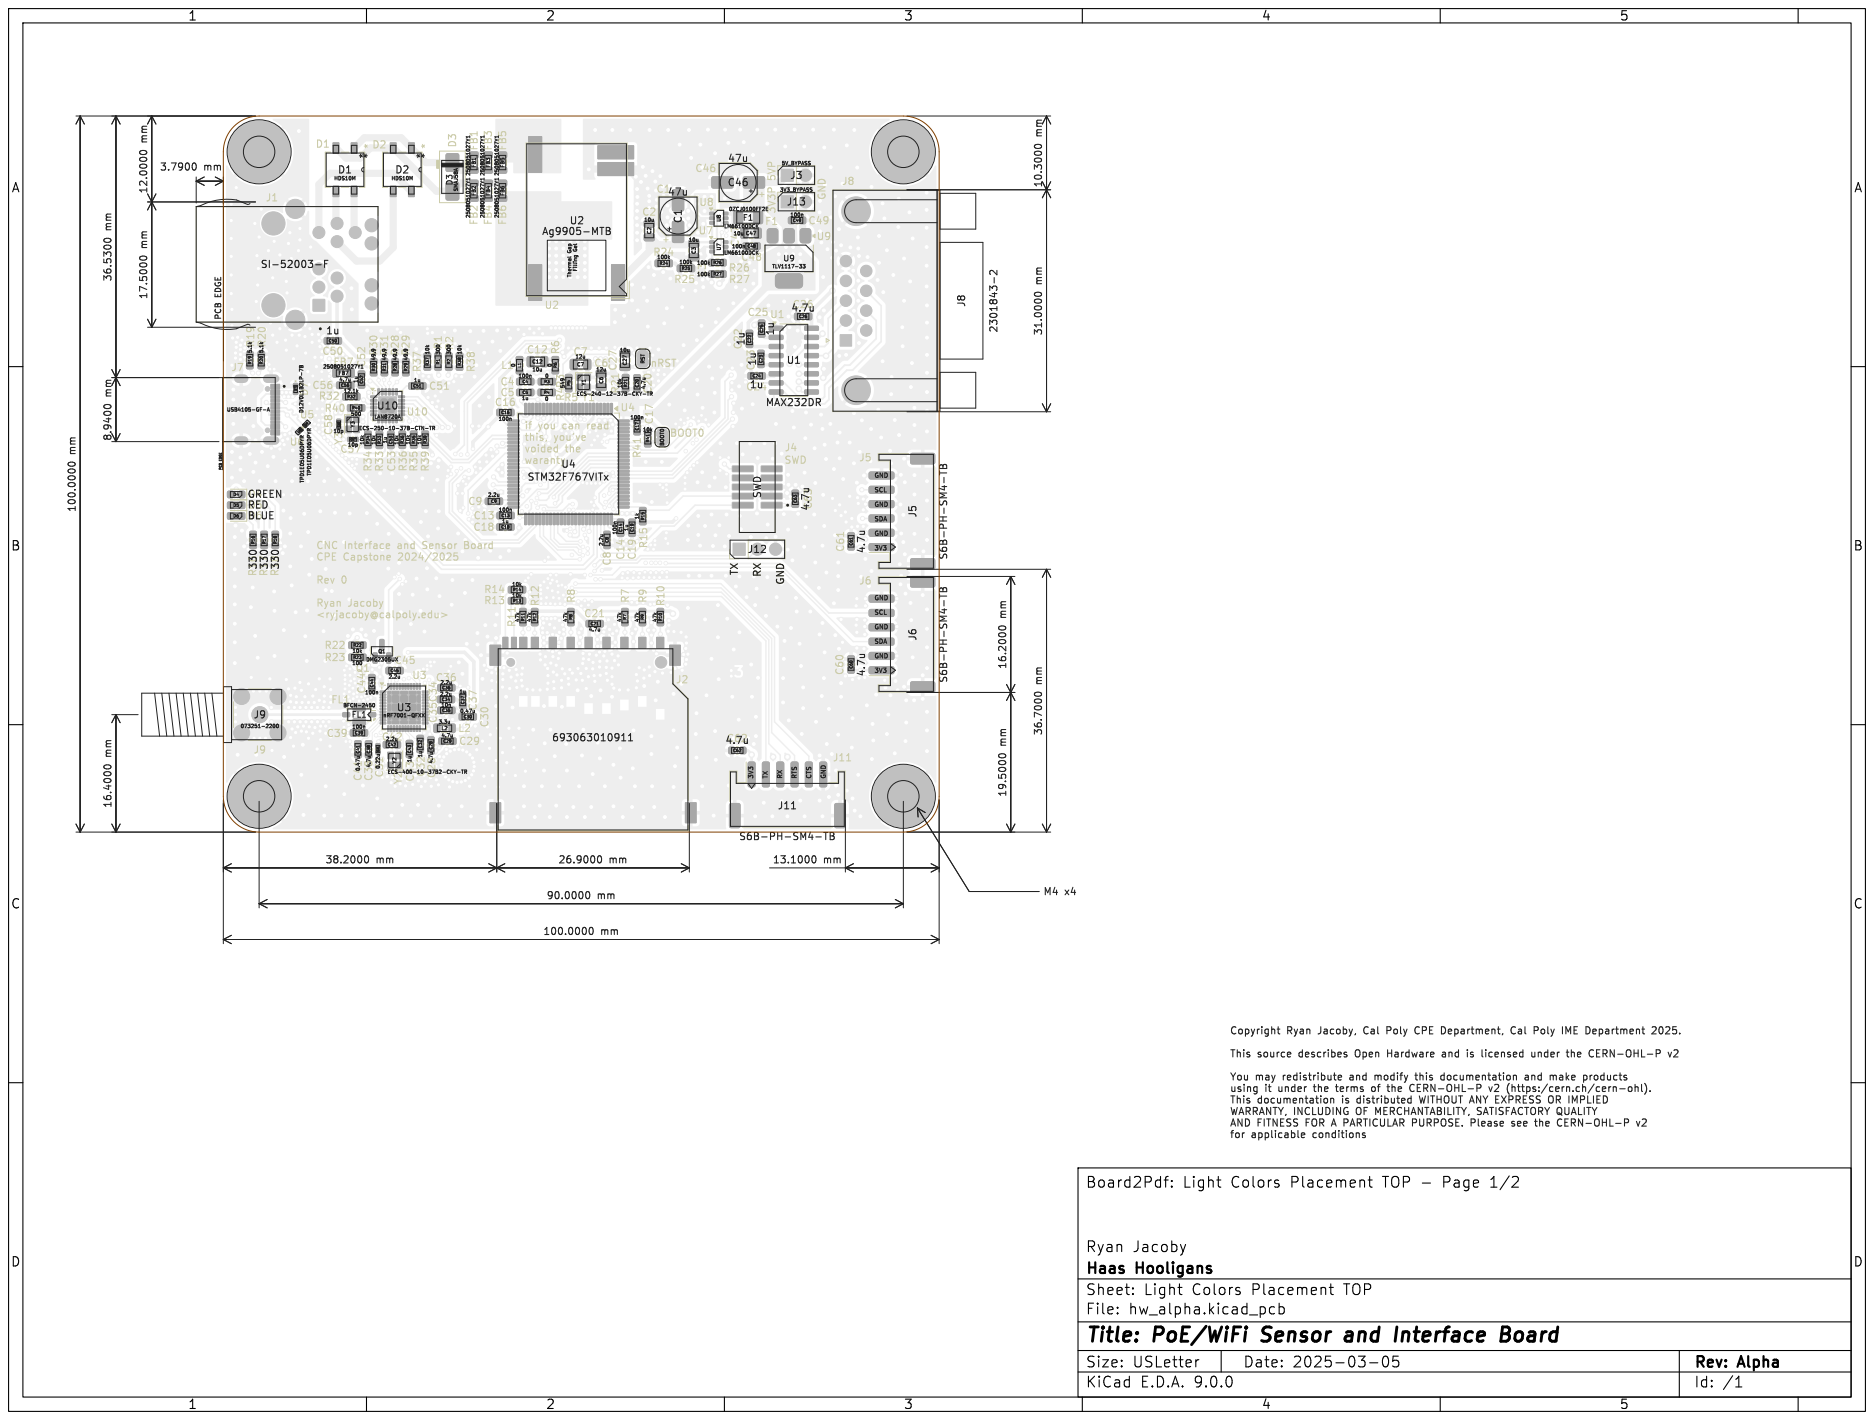
[picture p29: page 1]

if you can read
this, you've

Id: /1 Title: PoE/WiFi Sensor and Interface Board

# Fuse Bypass 5VP

1 | 2 | 3 | 4 | 5

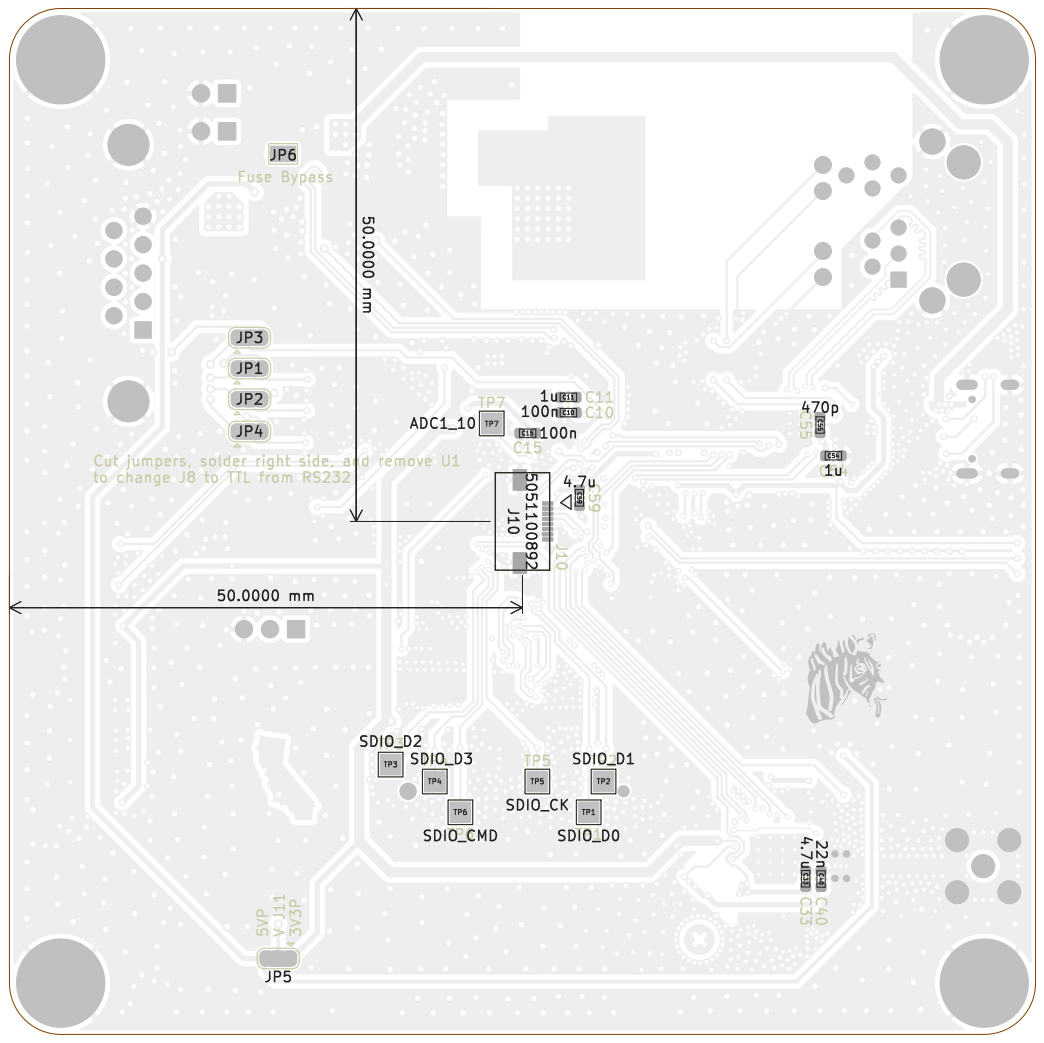
[picture p30: page 2]

V J11 3V3P Cut jumpers, solder right side, and remove U1

Id: /1 Title: PoE/WiFi Sensor and Interface Board
