Yexall/CPE-450.Capstone/Hardware/IIS3DWB_breakout_beta/plots/IIS3DWB_breakout_beta__Assembly.pdf

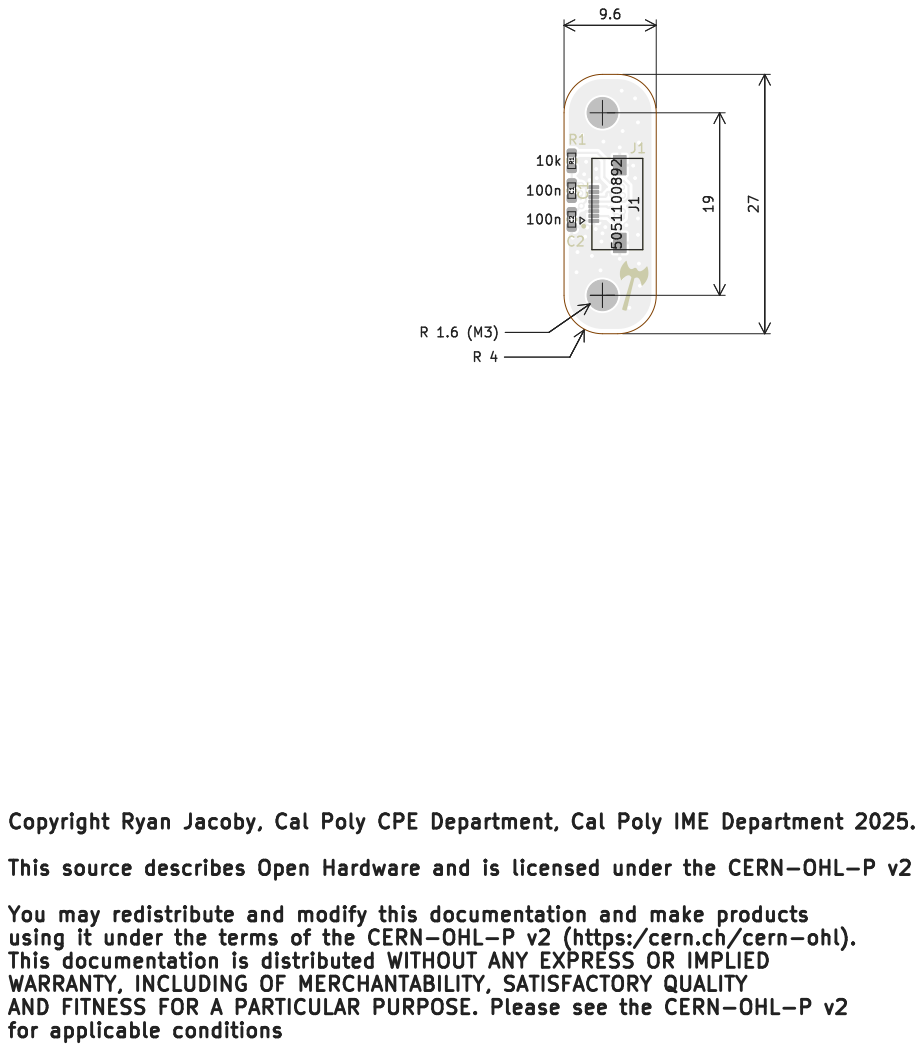
[picture p31: page 1]
J1 Copyright; Ryan Jacoby, Cal; Poly; CPE; Department,; Cal Poly; IME Department 2025. This source; describes; Open; Hardware and is licensed; under the; CERN-OHL-P; v2 You may redistribute; and modify; this; documentation; and; make; products; using it under; the terms of; the; (https:/cern.ch/cern-ohl). This documentation; distributed; WITHOUT; ANY; EXPRESS; IMPLIED WARRANTY,; INCLUDING OF; MERCHANTABILITY, SATISFACTORY QUALITY AND; FITNESS; FOR A; PARTICULAR PURPOSE. Please see the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

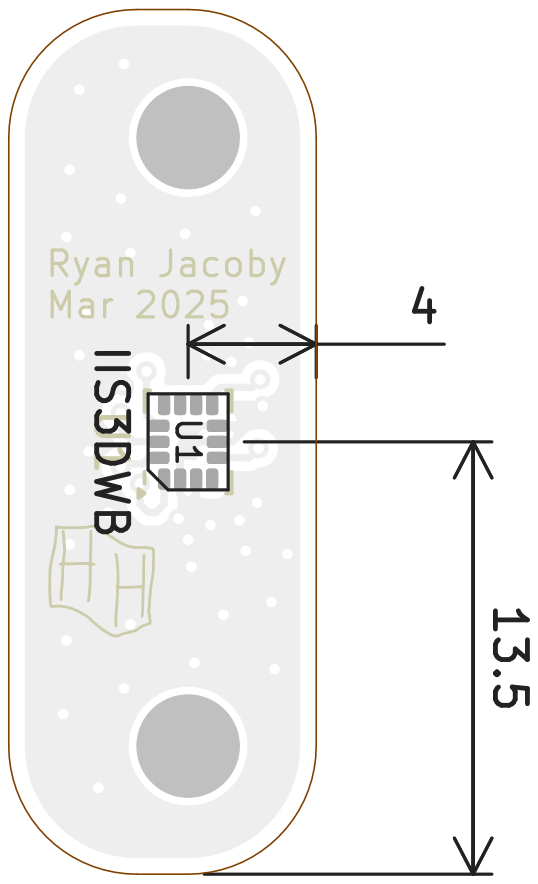
[picture p32: page 2]
Ryan Jacoby Mar 2025 U1; 13.5 IIS3DWB; D Date: 2025-03-08 KiCad; E.D.A. 9.0.0 Size: USLetter; Rev:; Beta; Id: /1 Title: IIS3DWB Breakout File: IIS3DWB_breakout_beta.kicad_pcb Sheet: Light Colors; Placement; BOT Haas; Hooligans; Ryan Jacoby Board2Pdf:; Light Colors; BOT -; Page 2/2
