Yexall/CPE-450.Capstone/Hardware/IIS3DWB_breakout_beta/IIS3DWB_breakout_beta.kicad_pcb

## KiCad design Hardware/IIS3DWB_breakout_beta/IIS3DWB_breakout_beta.kicad_pcb (2025-03-24)

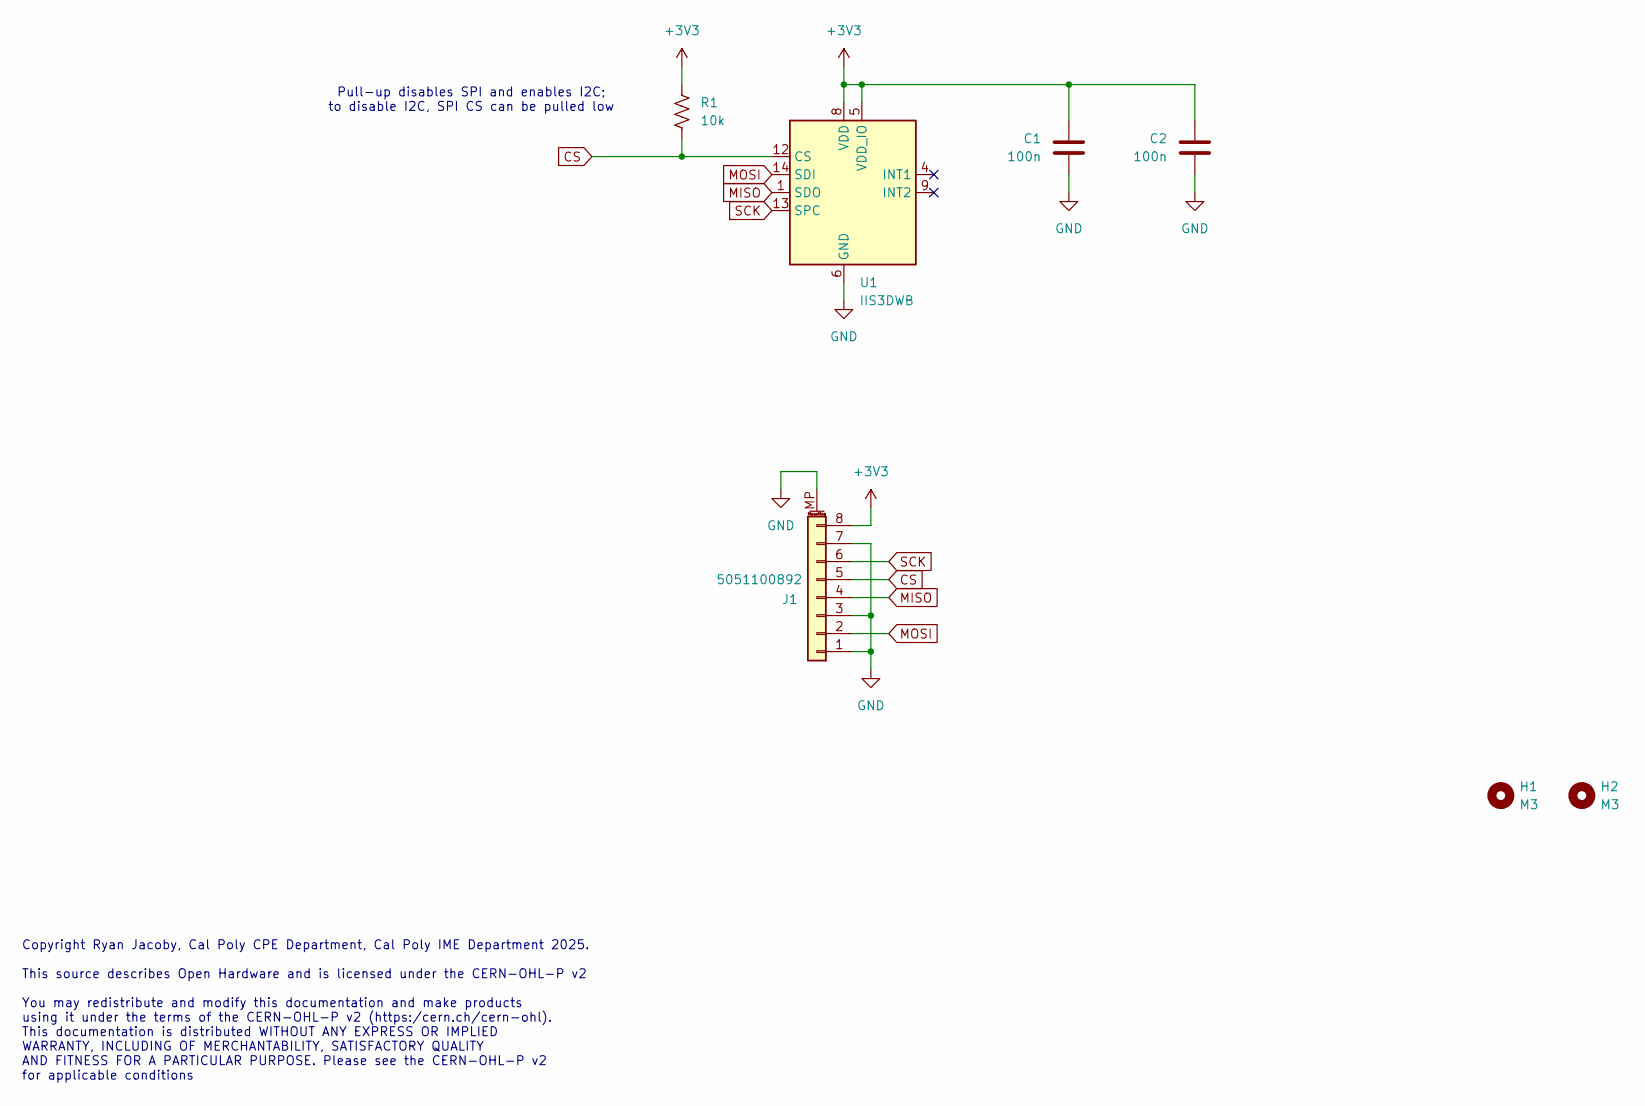
[picture p33: schematic IIS3DWB_breakout_beta.kicad_sch, IIS3DWB Vibration Sensor Breakout]

Parts:
C1, C2: 100n; C_0603_1608Metric
H1, H2: M3; MountingHole_3.2mm_M3
J1: 5051100892; CON_5051100892_MOL
R1: 10k; R_0603_1608Metric
U1: IIS3DWB; LGA-14_3x2.5mm_P0.5mm_LayoutBorder3x4y; MPN IIS3DWBTR

Connections:
+3V3: C1.1, C2.1, J1.8, R1.1, U1.5 (VDD_IO), U1.8 (VDD)
CS: J1.5, R1.2, U1.12 (CS)
GND: C1.2, C2.2, J1.1, J1.3, J1.7, J1.MP (MountPin), U1.2 (GND), U1.3 (GND), U1.6 (GND), U1.7 (GND)
MISO: J1.4, U1.1 (SDO)
MOSI: J1.2, U1.14 (SDI)
SCK: J1.6, U1.13 (SPC)

Notes on the sheet:
Copyright Ryan Jacoby, Cal Poly CPE Department, Cal Poly IME Department 2025. This source describes Open Hardware and is licensed under the CERN-OHL-P v2 You may redistribute and modify this documentation and make products using it under the terms of the CERN-OHL-P v2 (https:/cern.ch/cern-ohl). Thi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
Pull-up disables SPI and enables I2C; to disable I2C, SPI CS can be pulled low

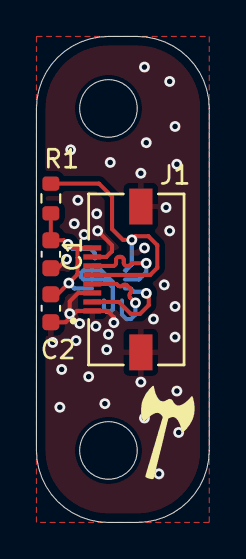
[picture p34: board IIS3DWB_breakout_beta.kicad_pcb from above]

Board: 2 copper layers, 9.6 x 27.0 mm, 7 parts (1 on the bottom side), 6 nets.
