Yexall/CPE-450.Capstone/Hardware/hw_alpha/hw_alpha.kicad_pcb

## KiCad design Hardware/hw_alpha/hw_alpha.kicad_pcb (2025-03-24)

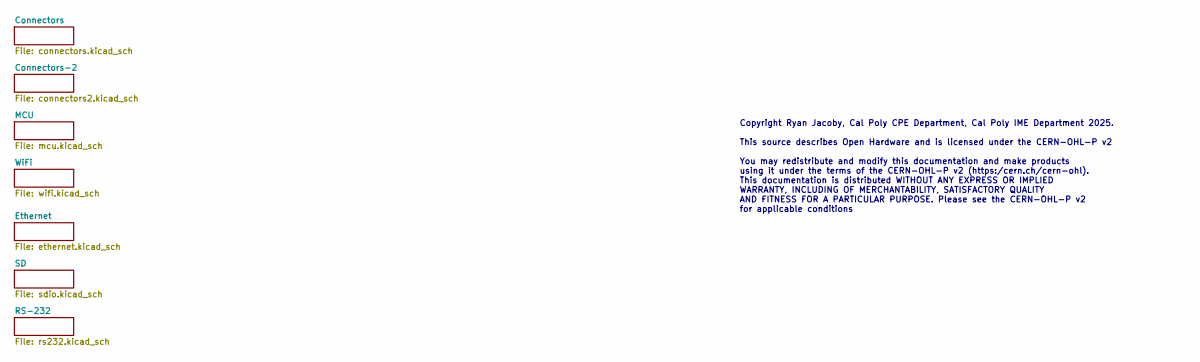
[picture p35: schematic hw_alpha.kicad_sch, Data Board PoE Main Page]

Notes on the sheet:
Copyright Ryan Jacoby, Cal Poly CPE Department, Cal Poly IME Department 2025. This source describes Open Hardware and is licensed under the CERN-OHL-P v2 You may redistribute and modify this documentation and make products using it under the terms of the CERN-OHL-P v2 (https:/cern.ch/cern-ohl). Thi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

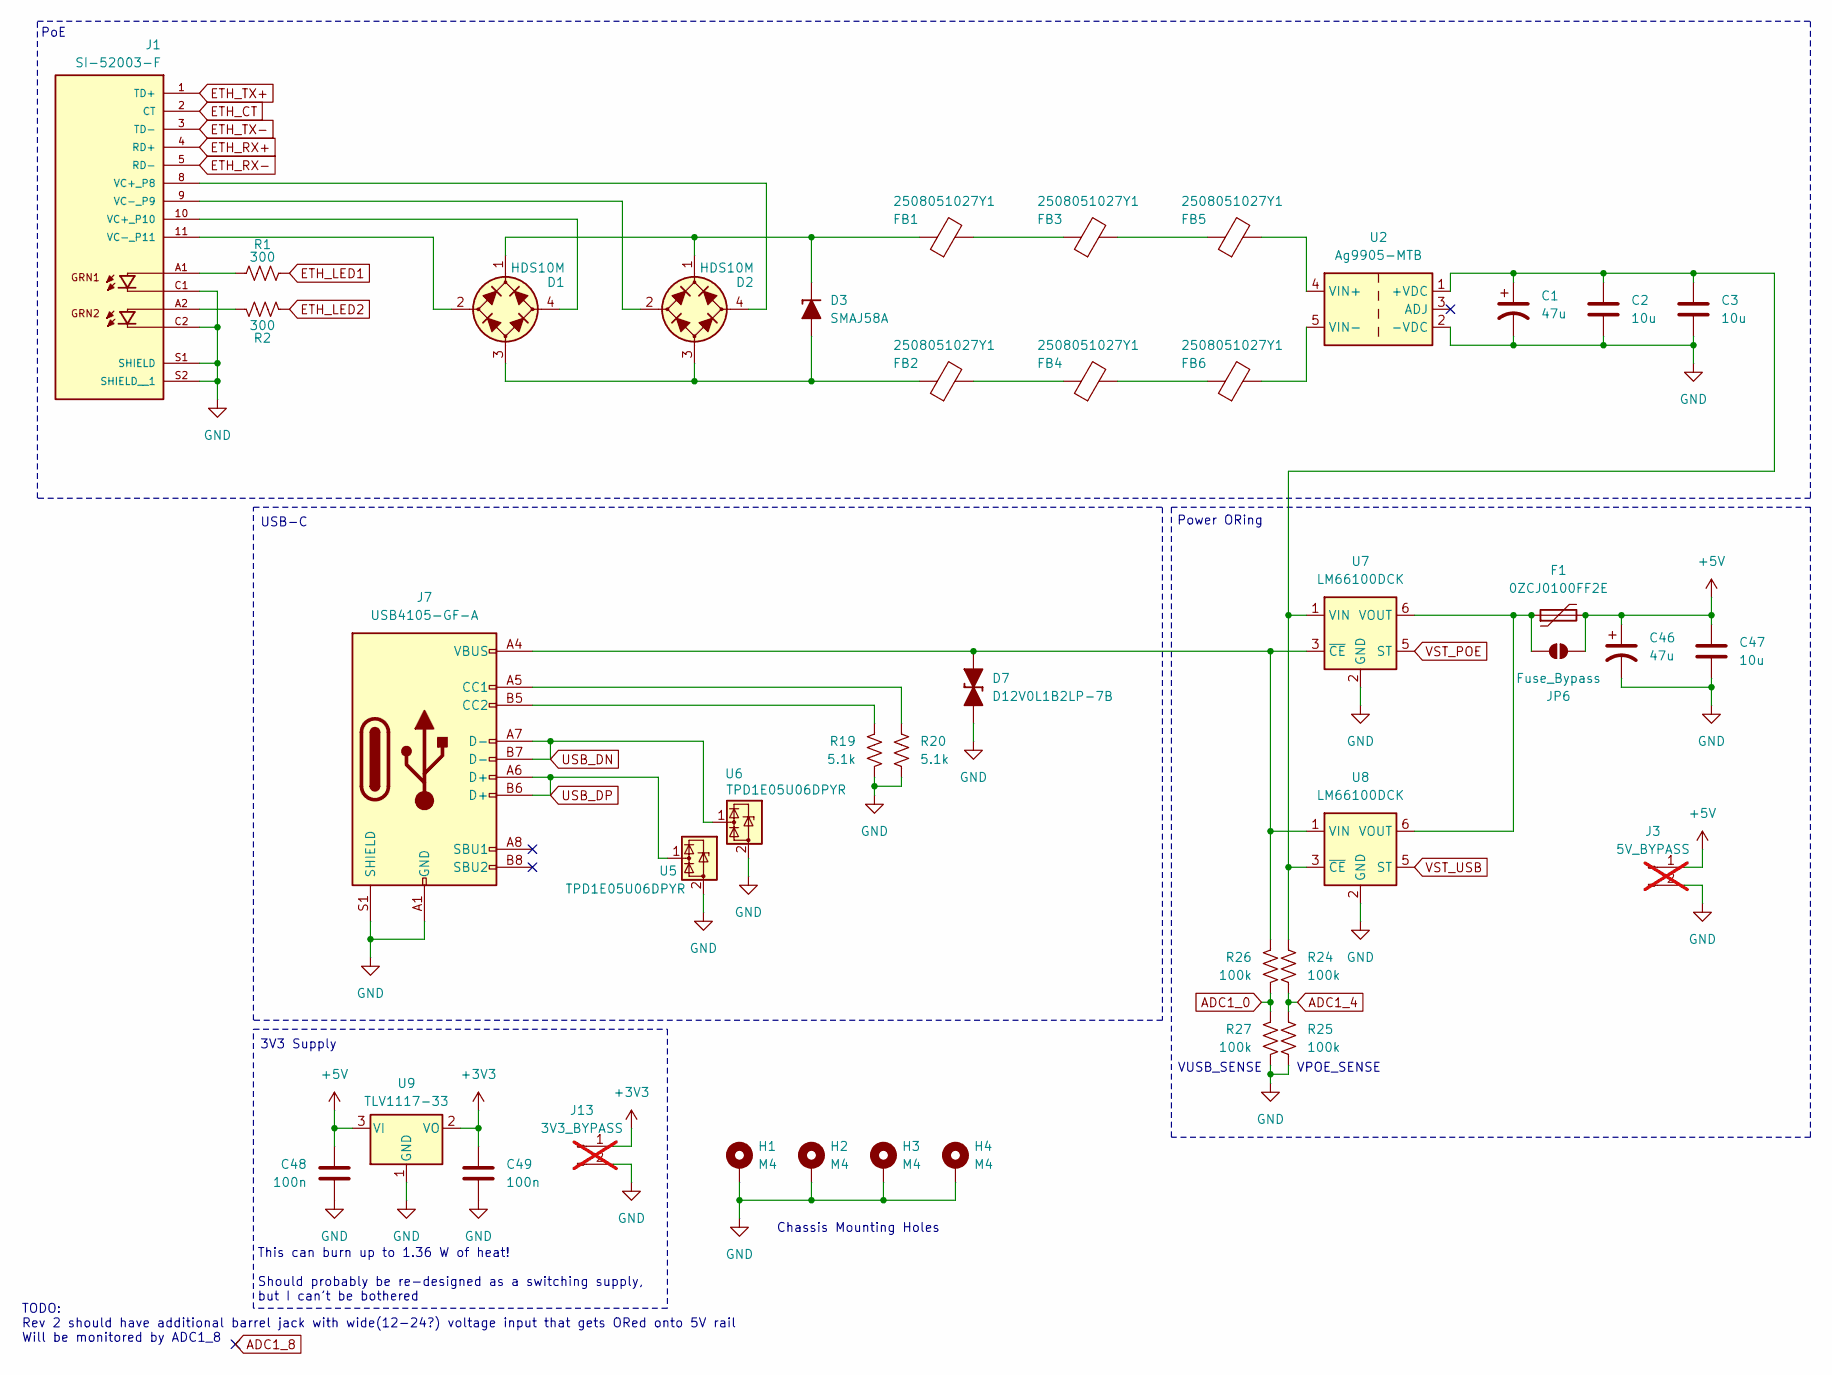
[picture p36: schematic connectors.kicad_sch, Power Connectors and PoE Isolation]

Parts:
C1, C46: 47u; CP_Elec_5x5.4
C2, C3, C47: 10u; C_0805_2012Metric
C48, C49: 100n; C_0603_1608Metric
D1, D2: HDS10M; HDS_DIO
D3: SMAJ58A; D_SMA
D7: D12V0L1B2LP-7B; D_0402_1005Metric
F1: 0ZCJ0100FF2E; Fuse_1206_3216Metric
FB1, FB2, FB3, FB4, FB5, FB6: 2508051027Y1; L_0805_2012Metric
H1, H2, H3, H4: M4; MountingHole_4.3mm_M4_Pad_Via
J1: SI-52003-F; BEL_SI-52003-F
J3: 5V_BYPASS; PinSocket_1x02_P2.54mm_Vertical; not fitted
J7: USB4105-GF-A; GCT_USB4105-GF-A
J13: 3V3_BYPASS; PinSocket_1x02_P2.54mm_Vertical; not fitted
JP6: Fuse_Bypass; SolderJumper-2_P1.3mm_Open_TrianglePad1.0x1.5mm
R1, R2: 300; R_0603_1608Metric
R19, R20: 5.1k; R_0603_1608Metric
R24, R25, R26, R27: 100k; R_0603_1608Metric
U2: Ag9905-MTB; Converter_DCDC_Silvertel_AG99xxMTB_Hand_Solder
U5, U6: TPD1E05U06DPYR; Texas_DPY0002A_0.6x1mm_P0.65mm
U7, U8: LM66100DCK; SOT-363_SC-70-6
U9: TLV1117-33; SOT-223-3_TabPin2

Connections:
+3V3: C49.1, J13.1, U9.2 (VO); also elsewhere on the board
+5V: C46.1, C47.1, C48.1, F1.2, J3.1, JP6.2 (B), U9.3 (VI); also elsewhere on the board
ADC1_0: R26.2, R27.1; also elsewhere on the board
ADC1_4: R24.2, R25.1; also elsewhere on the board
ETH_CT: J1.2 (CT); also elsewhere on the board
ETH_LED1: R1.2; also elsewhere on the board
ETH_LED2: R2.2; also elsewhere on the board
ETH_RX+: J1.4 (RD+); also elsewhere on the board
ETH_RX-: J1.5 (RD-); also elsewhere on the board
ETH_TX+: J1.1 (TD+); also elsewhere on the board
ETH_TX-: J1.3 (TD-); also elsewhere on the board
GND: C1.2, C2.2, C3.2, C46.2, C47.2, C48.2, C49.2, D7.1 (K), H1.1, H2.1, H3.1, H4.1, J1.C1, J1.C2, J1.S1 (SHIELD), J1.S2 (SHIELD__1), J3.2, J7.A1 (GND), J7.A12 (GND), J7.B1 (GND), J7.B12 (GND), J7.S1 (SHIELD), J13.2, R19.2, R20.2, R25.2, R27.2, U2.2 (-VDC), U5.2 (GND), U6.2 (GND), U7.2 (GND), U8.2 (GND), U9.1 (GND); also elsewhere on the board
unnamed: D1.2 (1), J1.11 (VC-_P11)
unnamed: D1.4 (2), J1.10 (VC+_P10)
unnamed: D1.1 (+), D2.1 (+), D3.1 (K), FB1.1
unnamed: D1.3 (-), D2.3 (-), D3.2 (A), FB2.1
unnamed: D2.2 (1), J1.9 (VC-_P9)
unnamed: D2.4 (2), J1.8 (VC+_P8)
unnamed: D7.2 (A), J7.A4 (VBUS), J7.A9 (VBUS), J7.B4 (VBUS), J7.B9 (VBUS), R26.1, U7.3 (~CE), U8.1 (VIN)
unnamed: FB1.2, FB3.1
unnamed: FB2.2, FB4.1
unnamed: FB3.2, FB5.1
unnamed: FB4.2, FB6.1
unnamed: J1.A1, R1.1
unnamed: J1.A2, R2.1
unnamed: J7.A5 (CC1), R20.1
unnamed: J7.B5 (CC2), R19.1
unnamed: F1.1, JP6.1 (A), U7.6 (VOUT), U8.6 (VOUT)
unnamed: C1.1, C2.1, C3.1, R24.1, U2.1 (+VDC), U7.1 (VIN), U8.3 (~CE)
unnamed: FB5.2, U2.4 (VIN+)
unnamed: FB6.2, U2.5 (VIN-)
USB_DN: J7.A7 (D-), J7.B7 (D-), U6.1 (I/O); also elsewhere on the board
USB_DP: J7.A6 (D+), J7.B6 (D+), U5.1 (I/O); also elsewhere on the board
VST_POE: U7.5 (ST); also elsewhere on the board
VST_USB: U8.5 (ST); also elsewhere on the board

Notes on the sheet:
PoE
USB-C
Chassis Mounting Holes
This can burn up to 1.36 W of heat! Should probably be re-designed as a switching supply, but I can't be bothered
VPOE_SENSE
Power ORing
VUSB_SENSE
TODO: Rev 2 should have additional barrel jack with wide(12-24?) voltage input that gets ORed onto 5V rail Will be monitored by ADC1_8
3V3 Supply

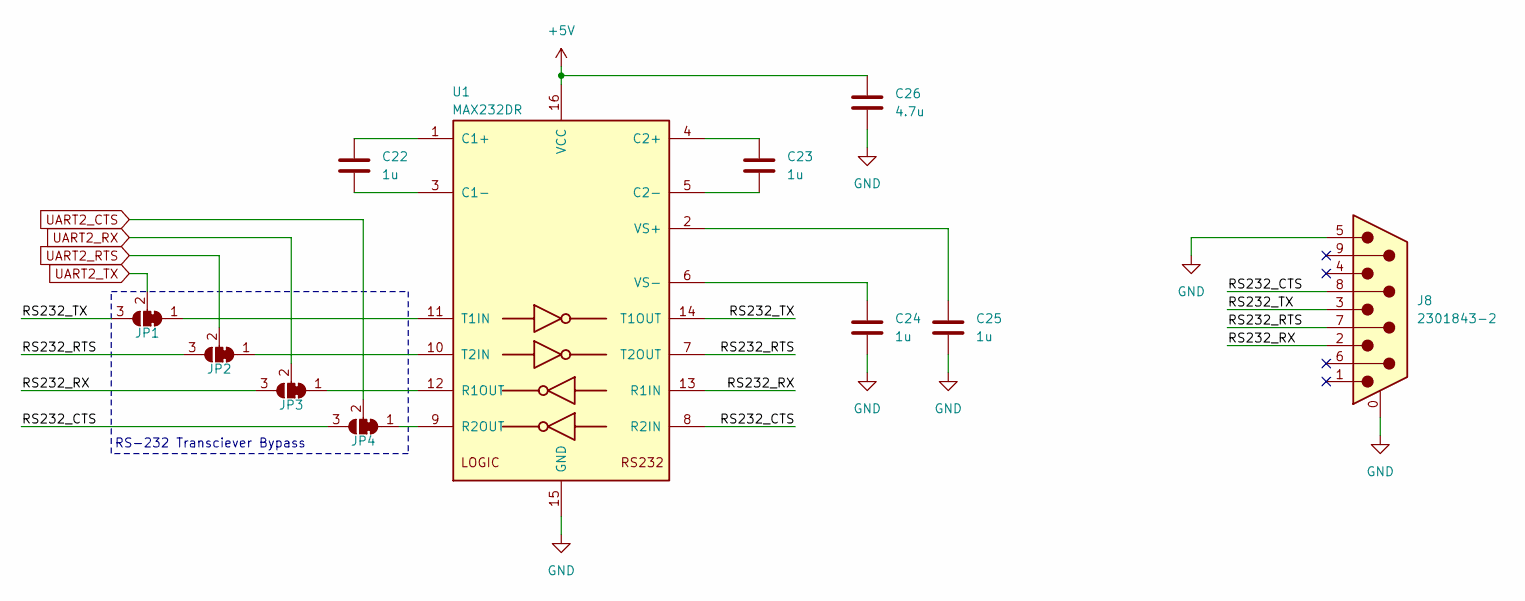
[picture p37: schematic rs232.kicad_sch, RS-232 Transciever]

Parts:
C22, C23, C24, C25: 1u; C_0603_1608Metric
C26: 4.7u; C_0603_1608Metric
J8: 2301843-2; DSUB-9_Pins_Horizontal_P2.77x2.84mm_EdgePinOffset9.90mm_Hou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
JP1, JP2, JP3, JP4: SolderJumper_3_Bridged12; SolderJumper-3_P1.3mm_Bridged12_RoundedPad1.0x1.5mm
U1: MAX232DR; SOIC-16_3.9x9.9mm_P1.27mm

Connections:
+5V: C26.1, U1.16 (VCC); also elsewhere on the board
/RS-232/RS232_CTS: J8.8, JP4.3 (B), U1.8 (R2IN)
/RS-232/RS232_RTS: J8.7, JP2.3 (B), U1.7 (T2OUT)
/RS-232/RS232_RX: J8.2, JP3.3 (B), U1.13 (R1IN)
/RS-232/RS232_TX: J8.3, JP1.3 (B), U1.14 (T1OUT)
GND: C24.2, C25.2, C26.2, J8.0 (PAD), J8.5, U1.15 (GND); also elsewhere on the board
unnamed: JP1.1 (A), U1.11 (T1IN)
unnamed: JP2.1 (A), U1.10 (T2IN)
unnamed: JP3.1 (A), U1.12 (R1OUT)
unnamed: JP4.1 (A), U1.9 (R2OUT)
unnamed: C22.1, U1.1 (C1+)
unnamed: C22.2, U1.3 (C1-)
unnamed: C23.1, U1.4 (C2+)
unnamed: C23.2, U1.5 (C2-)
unnamed: C25.1, U1.2 (VS+)
unnamed: C24.1, U1.6 (VS-)
UART2_CTS: JP4.2 (C); also elsewhere on the board
UART2_RTS: JP2.2 (C); also elsewhere on the board
UART2_RX: JP3.2 (C); also elsewhere on the board
UART2_TX: JP1.2 (C); also elsewhere on the board

Notes on the sheet:
RS-232 Transciever Bypass

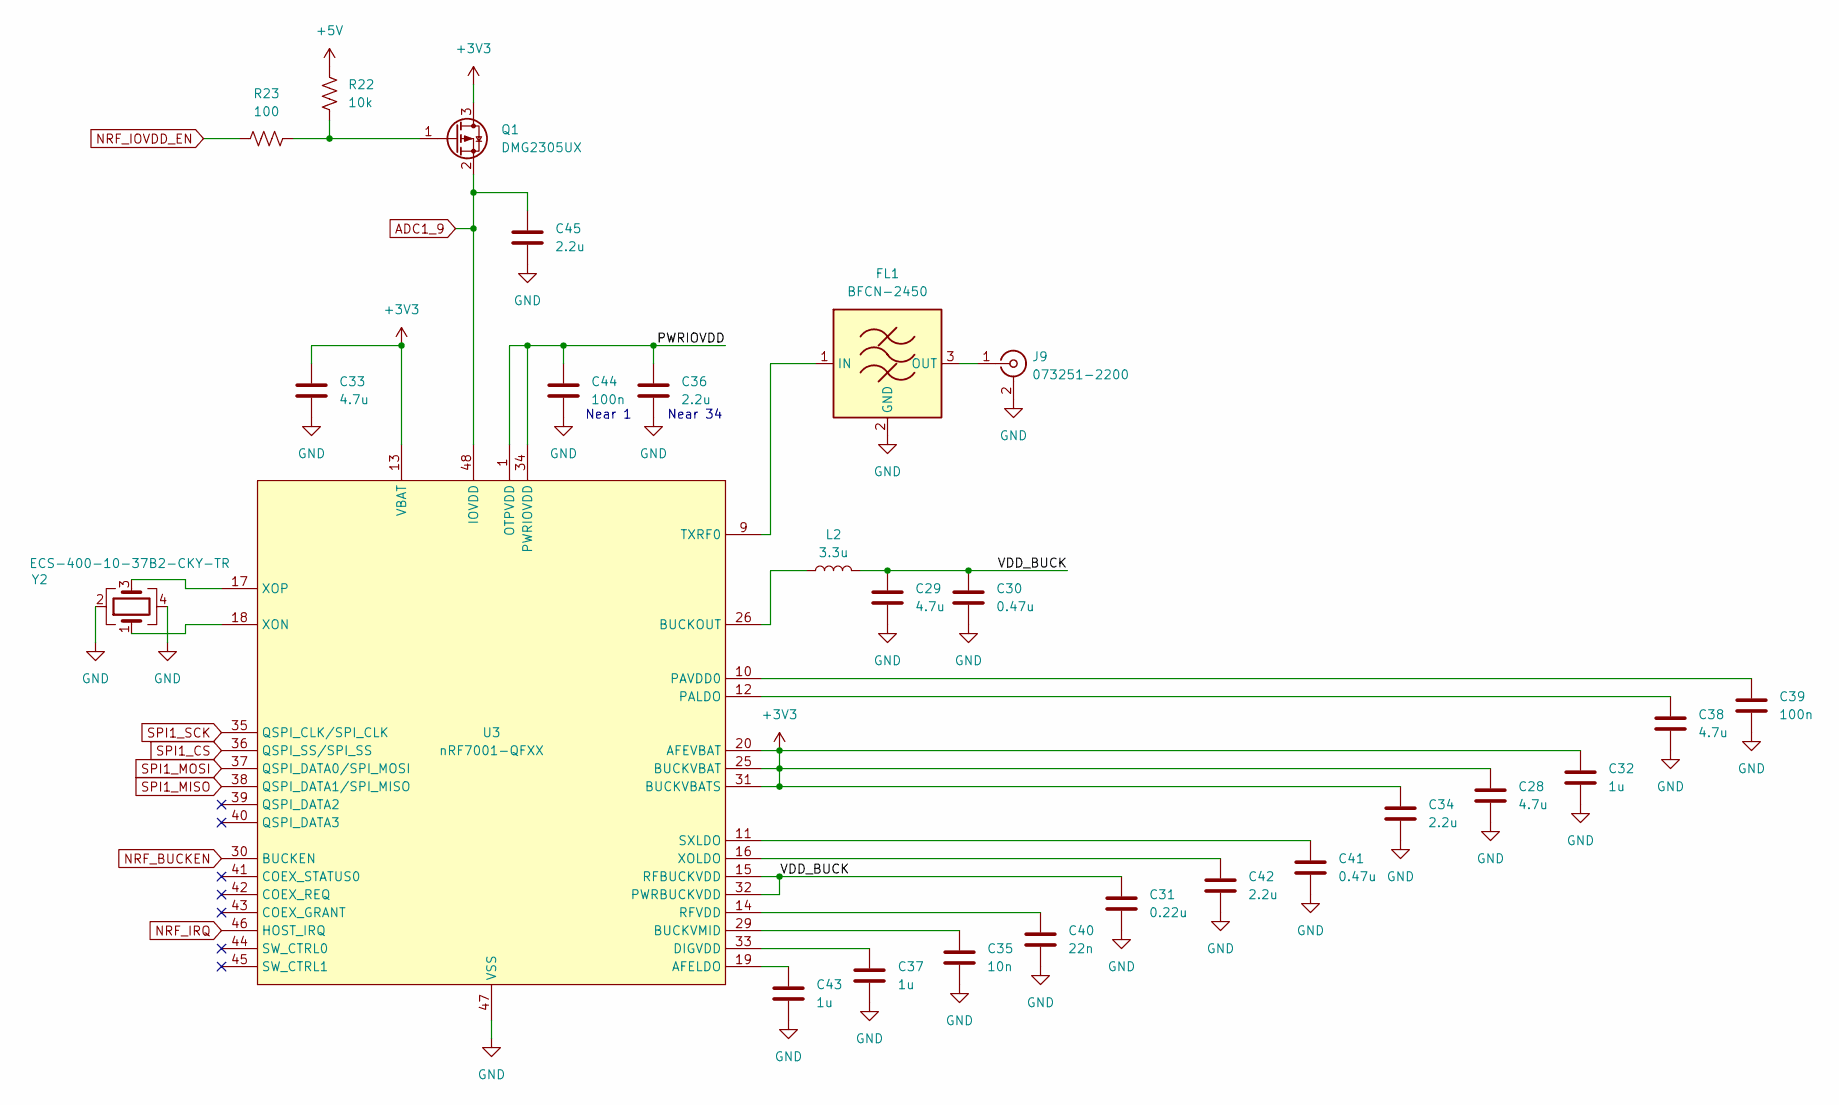
[picture p38: schematic wifi.kicad_sch, WiFi Coprocessor]

Parts:
C28, C29, C33, C38: 4.7u; C_0603_1608Metric
C30, C41: 0.47u; C_0603_1608Metric
C31: 0.22u; C_0402_1005Metric
C32, C37, C43: 1u; C_0603_1608Metric
C34, C36, C42, C45: 2.2u; C_0603_1608Metric
C35: 10n; C_0603_1608Metric
C39, C44: 100n; C_0603_1608Metric
C40: 22n; C_0603_1608Metric
FL1: BFCN-2450; Filter_Mini-Circuits_FV1206-4
J9: 073251-2200; SMA_Molex_73251-2200_Horizontal
L2: 3.3u; L_0805_2012Metric
Q1: DMG2305UX; SOT-23
R22: 10k; R_0603_1608Metric
R23: 100; R_0603_1608Metric
U3: nRF7001-QFXX; QFN-48-1EP_6x6mm_P0.4mm_EP4.6x4.6mm_ThermalVias
Y2: ECS-400-10-37B2-CKY-TR; Crystal_SMD_2016-4Pin_2.0x1.6mm

Connections:
+3V3: C28.1, C32.1, C33.1, C34.1, Q1.3 (D), U3.13 (VBAT), U3.20 (AFEVBAT), U3.25 (BUCKVBAT), U3.31 (BUCKVBATS); also elsewhere on the board
+5V: R22.1; also elsewhere on the board
/WiFi/PWRIOVDD: C36.1, C44.1, U3.1 (OTPVDD), U3.34 (PWRIOVDD)
/WiFi/VDD_BUCK: C29.1, C30.1, C31.1, L2.2, U3.15 (RFBUCKVDD), U3.32 (PWRBUCKVDD)
ADC1_9: C45.1, Q1.2 (S), U3.48 (IOVDD); also elsewhere on the board
GND: C28.2, C29.2, C30.2, C31.2, C32.2, C33.2, C34.2, C35.2, C36.2, C37.2, C38.2, C39.2, C40.2, C41.2, C42.2, C43.2, C44.2, C45.2, FL1.2 (GND), FL1.4 (GND), J9.2 (Ext), U3.8 (PAVDD1), U3.27 (BUCKVSS), U3.28 (BUCKVSS), U3.47 (VSS), U3.49 (EP), Y2.2, Y2.4; also elsewhere on the board
NRF_BUCKEN: U3.30 (BUCKEN); also elsewhere on the board
NRF_IOVDD_EN: R23.1; also elsewhere on the board
NRF_IRQ: U3.46 (HOST_IRQ); also elsewhere on the board
unnamed: FL1.1 (IN), U3.9 (TXRF0)
unnamed: FL1.3 (OUT), J9.1 (In)
unnamed: Q1.1 (G), R22.2, R23.2
unnamed: C43.1, U3.19 (AFELDO)
unnamed: L2.1, U3.26 (BUCKOUT)
unnamed: C35.1, U3.29 (BUCKVMID)
unnamed: C37.1, U3.33 (DIGVDD)
unnamed: C38.1, U3.12 (PALDO)
unnamed: C39.1, U3.10 (PAVDD0)
unnamed: C40.1, U3.14 (RFVDD)
unnamed: C41.1, U3.11 (SXLDO)
unnamed: C42.1, U3.16 (XOLDO)
unnamed: U3.18 (XON), Y2.1
unnamed: U3.17 (XOP), Y2.3
SPI1_CS: U3.36 (QSPI_SS/SPI_SS); also elsewhere on the board
SPI1_MISO: U3.38 (QSPI_DATA1/SPI_MISO); also elsewhere on the board
SPI1_MOSI: U3.37 (QSPI_DATA0/SPI_MOSI); also elsewhere on the board
SPI1_SCK: U3.35 (QSPI_CLK/SPI_CLK); also elsewhere on the board

Notes on the sheet:
Near 34
Near 1

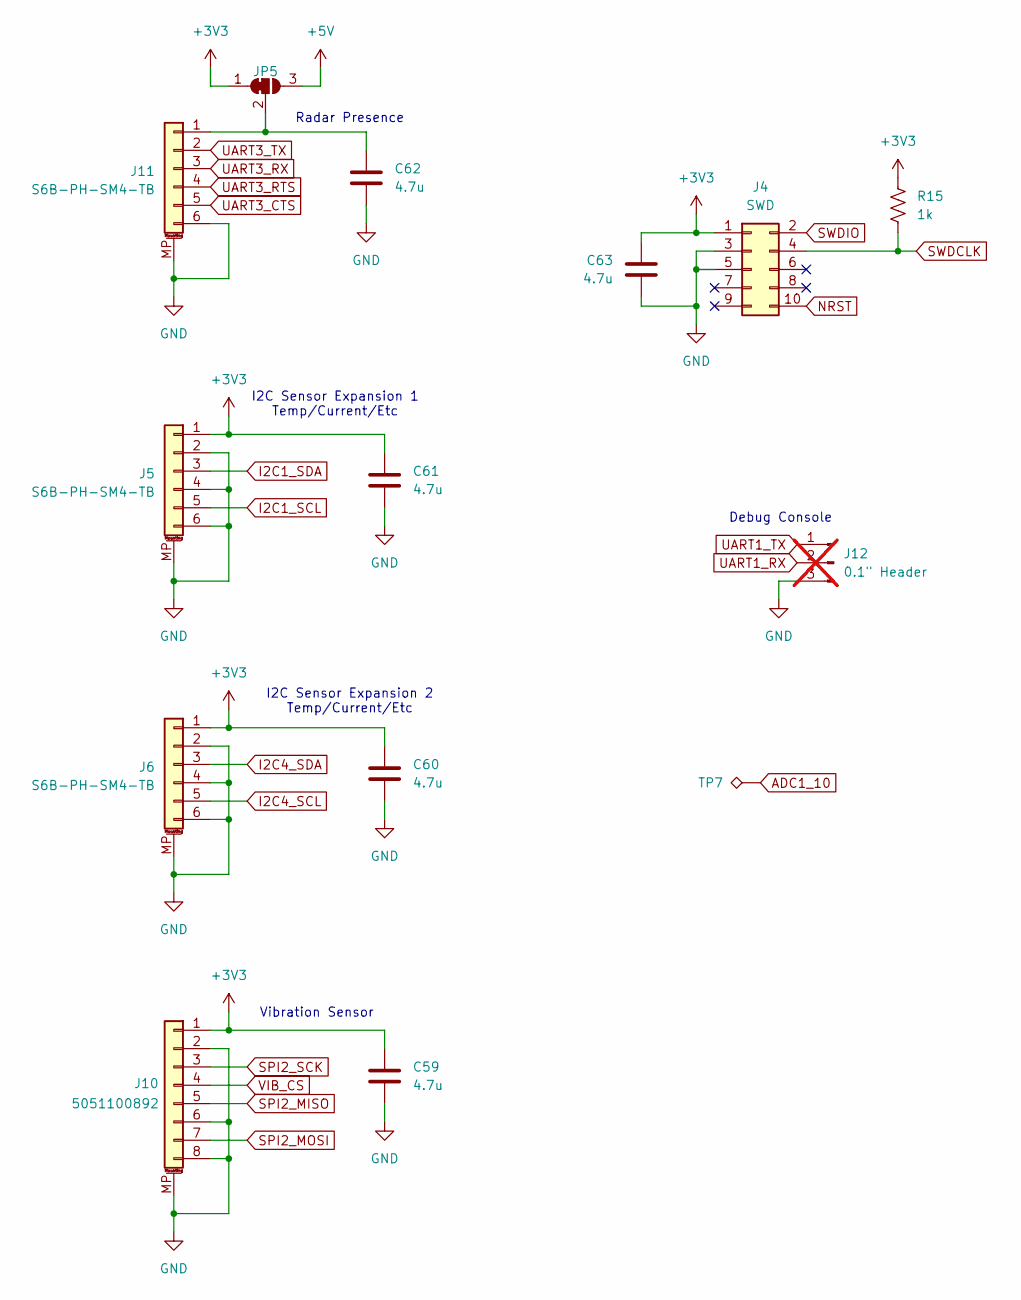
[picture p39: schematic connectors2.kicad_sch, Data and Debug Connectors]

Parts:
C59, C60, C61, C62, C63: 4.7u; C_0603_1608Metric
J4: SWD; CNC_3220-10-0300-00
J5, J6, J11: S6B-PH-SM4-TB; JST_PH_S6B-PH-SM4-TB_1x06-1MP_P2.00mm_Horizontal
J10: 5051100892; CON_5051100892_MOL
J12: 0.1" Header; PinHeader_1x03_P2.54mm_Vertical; not fitted
JP5: SolderJumper_3_Bridged12; SolderJumper-3_P1.3mm_Bridged12_RoundedPad1.0x1.5mm
R15: 1k; R_0603_1608Metric
TP7: TestPoint_Alt; TestPoint_Pad_2.0x2.0mm

Connections:
+3V3: C59.1, C60.1, C61.1, C63.1, J4.1, J5.1, J6.1, J10.1, JP5.1 (A), R15.1; also elsewhere on the board
+5V: JP5.3 (B); also elsewhere on the board
ADC1_10: TP7.1; also elsewhere on the board
GND: C59.2, C60.2, C61.2, C62.2, C63.2, J4.3, J4.5, J5.2, J5.4, J5.6, J5.MP (MountPin), J6.2, J6.4, J6.6, J6.MP (MountPin), J10.2, J10.6, J10.8, J10.MP (MountPin), J11.6, J11.MP (MountPin), J12.3; also elsewhere on the board
I2C1_SCL: J5.5; also elsewhere on the board
I2C1_SDA: J5.3; also elsewhere on the board
I2C4_SCL: J6.5; also elsewhere on the board
I2C4_SDA: J6.3; also elsewhere on the board
NRST: J4.10; also elsewhere on the board
unnamed: C62.1, J11.1, JP5.2 (C)
SPI2_MISO: J10.5; also elsewhere on the board
SPI2_MOSI: J10.7; also elsewhere on the board
SPI2_SCK: J10.3; also elsewhere on the board
SWDCLK: J4.4, R15.2; also elsewhere on the board
SWDIO: J4.2; also elsewhere on the board
UART1_RX: J12.2; also elsewhere on the board
UART1_TX: J12.1; also elsewhere on the board
UART3_CTS: J11.5; also elsewhere on the board
UART3_RTS: J11.4; also elsewhere on the board
UART3_RX: J11.3; also elsewhere on the board
UART3_TX: J11.2; also elsewhere on the board
VIB_CS: J10.4; also elsewhere on the board

Notes on the sheet:
Radar Presence
I2C Sensor Expansion 1 Temp/Current/Etc
Vibration Sensor
Debug Console
I2C Sensor Expansion 2 Temp/Current/Etc

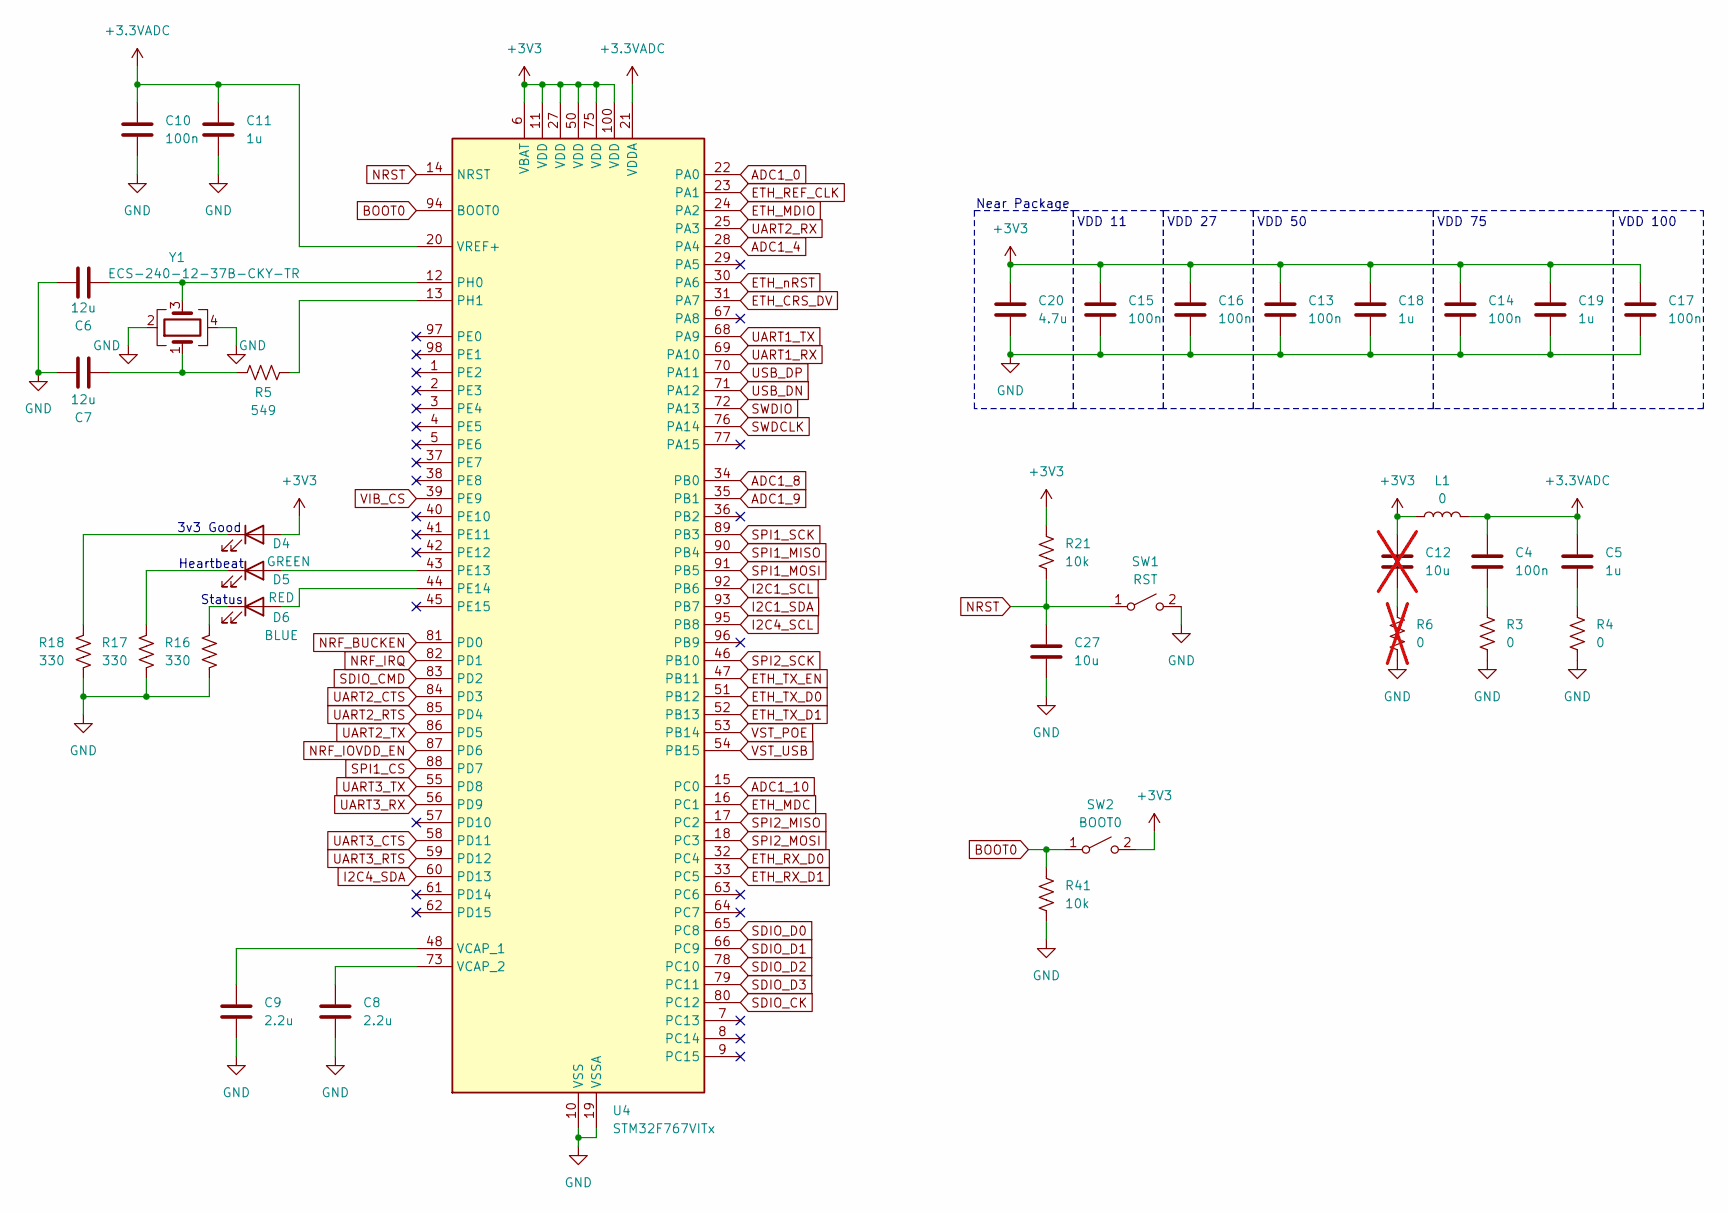
[picture p40: schematic mcu.kicad_sch, Microcontroller]

Parts:
C4, C10, C13, C14, C15, C16, C17: 100n; C_0603_1608Metric
C5, C11, C18, C19: 1u; C_0603_1608Metric
C6, C7: 12u; C_0805_2012Metric
C8, C9: 2.2u; C_0603_1608Metric
C12: 10u; C_0805_2012Metric; not fitted
C20: 4.7u; C_0603_1608Metric
C27: 10u; C_0805_2012Metric
D4: GREEN; LED_0603_1608Metric
D5: RED; LED_0603_1608Metric
D6: BLUE; LED_0603_1608Metric
L1: 0; R_0603_1608Metric
R3, R4: 0; R_0603_1608Metric
R5: 549; R_0603_1608Metric
R6: 0; R_0603_1608Metric; not fitted
R16, R17, R18: 330; R_0603_1608Metric
R21, R41: 10k; R_0603_1608Metric
SW1: RST; SolderJumper-2_P1.3mm_Open_RoundedPad1.0x1.5mm
SW2: BOOT0; SolderJumper-2_P1.3mm_Open_RoundedPad1.0x1.5mm
U4: STM32F767VITx; LQFP-100_14x14mm_P0.5mm
Y1: ECS-240-12-37B-CKY-TR; Crystal_SMD_2016-4Pin_2.0x1.6mm

Connections:
+3.3VADC: C4.1, C5.1, C10.1, C11.1, L1.2, U4.20 (VREF+), U4.21 (VDDA)
+3V3: C12.1, C13.1, C14.1, C15.1, C16.1, C17.1, C18.1, C19.1, C20.1, D4.2 (A), L1.1, R21.1, SW2.2 (B), U4.6 (VBAT), U4.11 (VDD), U4.27 (VDD), U4.50 (VDD), U4.75 (VDD), U4.100 (VDD); also elsewhere on the board
ADC1_0: U4.22 (PA0); also elsewhere on the board
ADC1_4: U4.28 (PA4); also elsewhere on the board
ADC1_8: U4.34 (PB0)
ADC1_9: U4.35 (PB1); also elsewhere on the board
ADC1_10: U4.15 (PC0); also elsewhere on the board
BOOT0: R41.1, SW2.1 (A), U4.94 (BOOT0)
ETH_CRS_DV: U4.31 (PA7); also elsewhere on the board
ETH_MDC: U4.16 (PC1); also elsewhere on the board
ETH_MDIO: U4.24 (PA2); also elsewhere on the board
ETH_REF_CLK: U4.23 (PA1); also elsewhere on the board
ETH_RX_D0: U4.32 (PC4); also elsewhere on the board
ETH_RX_D1: U4.33 (PC5); also elsewhere on the board
ETH_TX_D0: U4.51 (PB12); also elsewhere on the board
ETH_TX_D1: U4.52 (PB13); also elsewhere on the board
ETH_TX_EN: U4.47 (PB11); also elsewhere on the board
ETH_nRST: U4.30 (PA6); also elsewhere on the board
GND: C6.1, C7.1, C8.2, C9.2, C10.2, C11.2, C13.2, C14.2, C15.2, C16.2, C17.2, C18.2, C19.2, C20.2, C27.2, R3.2, R4.2, R6.2, R16.2, R17.2, R18.2, R41.2, SW1.2 (B), U4.10 (VSS), U4.19 (VSSA), U4.26 (VSS), U4.49 (VSS), U4.74 (VSS), U4.99 (VSS), Y1.2, Y1.4; also elsewhere on the board
I2C1_SCL: U4.92 (PB6); also elsewhere on the board
I2C1_SDA: U4.93 (PB7); also elsewhere on the board
I2C4_SCL: U4.95 (PB8); also elsewhere on the board
I2C4_SDA: U4.60 (PD13); also elsewhere on the board
NRF_BUCKEN: U4.81 (PD0); also elsewhere on the board
NRF_IOVDD_EN: U4.87 (PD6); also elsewhere on the board
NRF_IRQ: U4.82 (PD1); also elsewhere on the board
NRST: C27.1, R21.2, SW1.1 (A), U4.14 (NRST); also elsewhere on the board
unnamed: C4.2, R3.1
unnamed: C5.2, R4.1
unnamed: C7.2, R5.1, Y1.1
unnamed: C12.2, R6.1
unnamed: D4.1 (K), R18.1
unnamed: D5.2 (A), U4.43 (PE13)
unnamed: D5.1 (K), R17.1
unnamed: D6.2 (A), U4.44 (PE14)
unnamed: D6.1 (K), R16.1
unnamed: C6.2, U4.12 (PH0), Y1.3
unnamed: R5.2, U4.13 (PH1)
unnamed: C9.1, U4.48 (VCAP_1)
unnamed: C8.1, U4.73 (VCAP_2)
SDIO_CK: U4.80 (PC12); also elsewhere on the board
SDIO_CMD: U4.83 (PD2); also elsewhere on the board
SDIO_D0: U4.65 (PC8); also elsewhere on the board
SDIO_D1: U4.66 (PC9); also elsewhere on the board
SDIO_D2: U4.78 (PC10); also elsewhere on the board
SDIO_D3: U4.79 (PC11); also elsewhere on the board
SPI1_CS: U4.88 (PD7); also elsewhere on the board
SPI1_MISO: U4.90 (PB4); also elsewhere on the board
SPI1_MOSI: U4.91 (PB5); also elsewhere on the board
SPI1_SCK: U4.89 (PB3); also elsewhere on the board
SPI2_MISO: U4.17 (PC2); also elsewhere on the board
SPI2_MOSI: U4.18 (PC3); also elsewhere on the board
SPI2_SCK: U4.46 (PB10); also elsewhere on the board
SWDCLK: U4.76 (PA14); also elsewhere on the board
SWDIO: U4.72 (PA13); also elsewhere on the board
UART1_RX: U4.69 (PA10); also elsewhere on the board
UART1_TX: U4.68 (PA9); also elsewhere on the board
UART2_CTS: U4.84 (PD3); also elsewhere on the board
UART2_RTS: U4.85 (PD4); also elsewhere on the board
UART2_RX: U4.25 (PA3); also elsewhere on the board
UART2_TX: U4.86 (PD5); also elsewhere on the board
UART3_CTS: U4.58 (PD11); also elsewhere on the board
UART3_RTS: U4.59 (PD12); also elsewhere on the board
UART3_RX: U4.56 (PD9); also elsewhere on the board
UART3_TX: U4.55 (PD8); also elsewhere on the board
USB_DN: U4.71 (PA12); also elsewhere on the board
USB_DP: U4.70 (PA11); also elsewhere on the board
VIB_CS: U4.39 (PE9); also elsewhere on the board
VST_POE: U4.53 (PB14); also elsewhere on the board
VST_USB: U4.54 (PB15); also elsewhere on the board

Notes on the sheet:
Status
Heartbeat
VDD 11
VDD 100
VDD 27
VDD 50
3v3 Good
VDD 75
Near Package

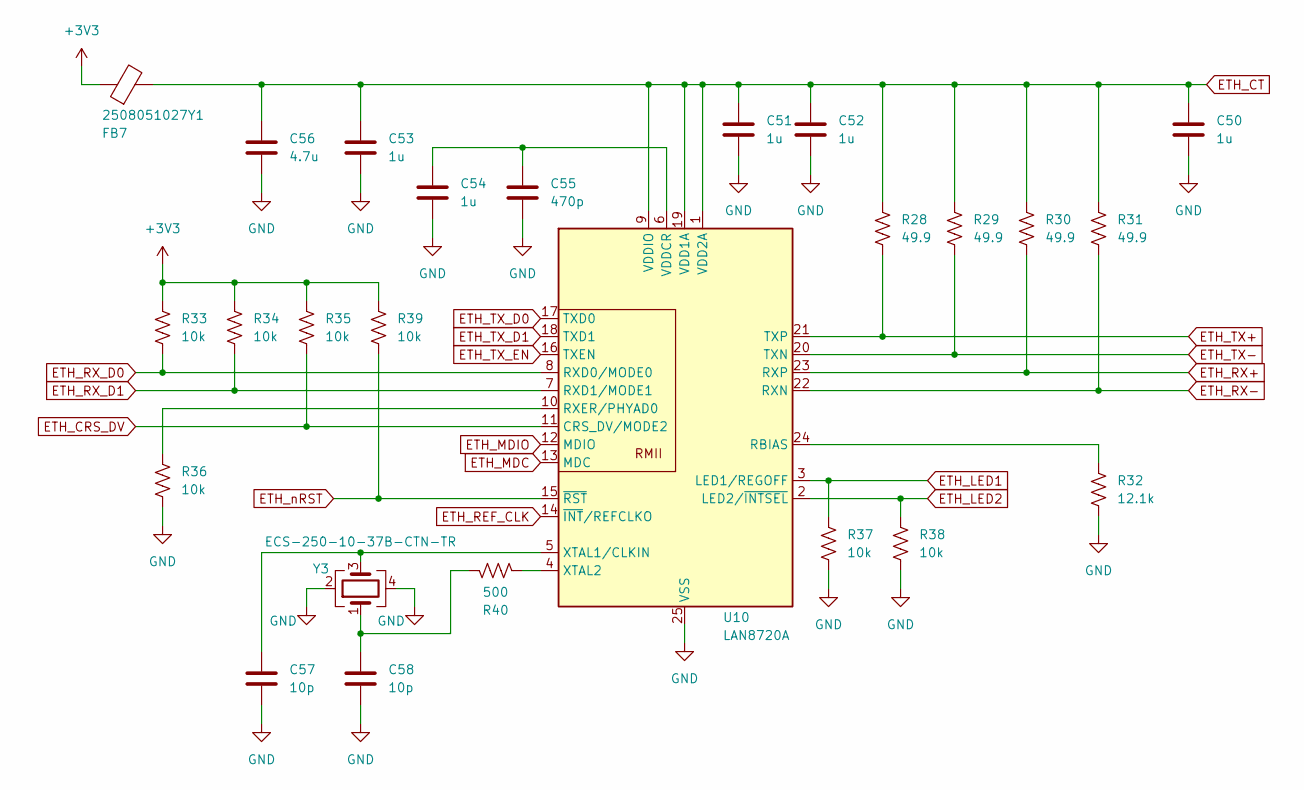
[picture p41: schematic ethernet.kicad_sch, Ethernet PHY]

Parts:
C50, C51, C52, C53, C54: 1u; C_0603_1608Metric
C55: 470p; C_0603_1608Metric
C56: 4.7u; C_0603_1608Metric
C57, C58: 10p; C_0402_1005Metric
FB7: 2508051027Y1; L_0805_2012Metric
R28, R29, R30, R31: 49.9; R_0603_1608Metric
R32: 12.1k; R_0603_1608Metric
R33, R34, R35, R36, R37, R38, R39: 10k; R_0603_1608Metric
R40: 500; R_0603_1608Metric
U10: LAN8720A; VQFN-24-1EP_4x4mm_P0.5mm_EP2.5x2.5mm_ThermalVias
Y3: ECS-250-10-37B-CTN-TR; Crystal_SMD_2016-4Pin_2.0x1.6mm

Connections:
+3V3: FB7.1, R33.1, R34.1, R35.1, R39.1; also elsewhere on the board
ETH_CRS_DV: R35.2, U10.11 (CRS_DV/MODE2); also elsewhere on the board
ETH_CT: C50.1, C51.1, C52.1, C53.1, C56.1, FB7.2, R28.1, R29.1, R30.1, R31.1, U10.1 (VDD2A), U10.9 (VDDIO), U10.19 (VDD1A); also elsewhere on the board
ETH_LED1: R37.1, U10.3 (LED1/REGOFF); also elsewhere on the board
ETH_LED2: R38.1, U10.2 (LED2/~INTSEL); also elsewhere on the board
ETH_MDC: U10.13 (MDC); also elsewhere on the board
ETH_MDIO: U10.12 (MDIO); also elsewhere on the board
ETH_REF_CLK: U10.14 (~INT/REFCLKO); also elsewhere on the board
ETH_RX+: R30.2, U10.23 (RXP); also elsewhere on the board
ETH_RX-: R31.2, U10.22 (RXN); also elsewhere on the board
ETH_RX_D0: R33.2, U10.8 (RXD0/MODE0); also elsewhere on the board
ETH_RX_D1: R34.2, U10.7 (RXD1/MODE1); also elsewhere on the board
ETH_TX+: R28.2, U10.21 (TXP); also elsewhere on the board
ETH_TX-: R29.2, U10.20 (TXN); also elsewhere on the board
ETH_TX_D0: U10.17 (TXD0); also elsewhere on the board
ETH_TX_D1: U10.18 (TXD1); also elsewhere on the board
ETH_TX_EN: U10.16 (TXEN); also elsewhere on the board
ETH_nRST: R39.2, U10.15 (~RST); also elsewhere on the board
GND: C50.2, C51.2, C52.2, C53.2, C54.2, C55.2, C56.2, C57.2, C58.2, R32.2, R36.2, R37.2, R38.2, U10.25 (VSS), Y3.2, Y3.4; also elsewhere on the board
unnamed: C58.1, R40.1, Y3.1
unnamed: R32.1, U10.24 (RBIAS)
unnamed: R36.1, U10.10 (RXER/PHYAD0)
unnamed: C54.1, C55.1, U10.6 (VDDCR)
unnamed: C57.1, U10.5 (XTAL1/CLKIN), Y3.3
unnamed: R40.2, U10.4 (XTAL2)
