Yexall/CPE-450.Capstone/Hardware/hw_alpha/hw_alpha.kicad_pcb

## KiCad design Hardware/hw_alpha/hw_alpha.kicad_pcb (continued)

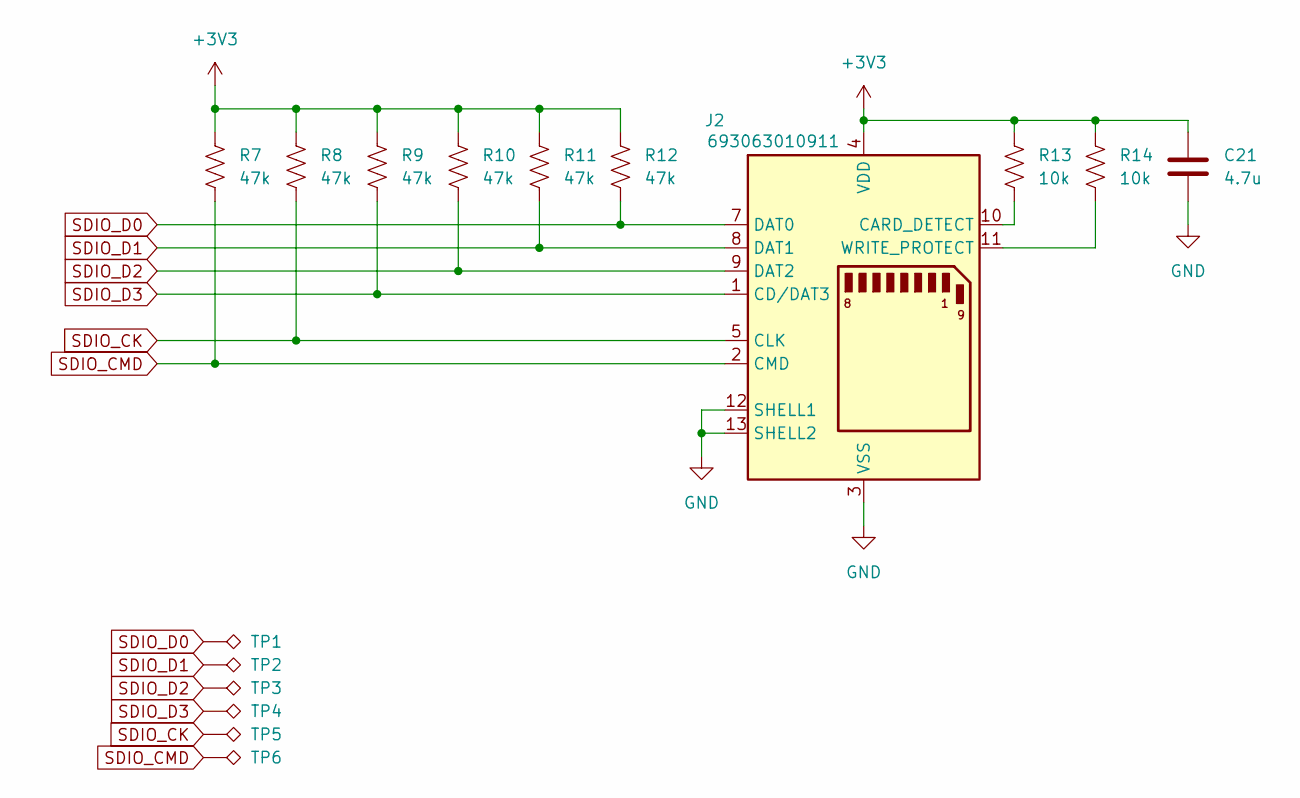
[picture p42: schematic sdio.kicad_sch, SD Card]

Parts:
C21: 4.7u; C_0603_1608Metric
J2: 693063010911
R7, R8, R9, R10, R11, R12: 47k; R_0603_1608Metric
R13, R14: 10k; R_0603_1608Metric
TP1, TP2, TP3, TP4, TP5, TP6: TestPoint_Alt; TestPoint_Pad_2.0x2.0mm

Connections:
+3V3: C21.1, J2.4 (VDD), R7.1, R8.1, R9.1, R10.1, R11.1, R12.1, R13.1, R14.1; also elsewhere on the board
GND: C21.2, J2.3 (VSS), J2.6 (VSS), J2.12 (SHELL1), J2.13 (SHELL2); also elsewhere on the board
unnamed: J2.10 (CARD_DETECT), R13.2
unnamed: J2.11 (WRITE_PROTECT), R14.2
SDIO_CK: J2.5 (CLK), R8.2, TP5.1; also elsewhere on the board
SDIO_CMD: J2.2 (CMD), R7.2, TP6.1; also elsewhere on the board
SDIO_D0: J2.7 (DAT0), R12.2, TP1.1; also elsewhere on the board
SDIO_D1: J2.8 (DAT1), R11.2, TP2.1; also elsewhere on the board
SDIO_D2: J2.9 (DAT2), R10.2, TP3.1; also elsewhere on the board
SDIO_D3: J2.1 (CD/DAT3), R9.2, TP4.1; also elsewhere on the board

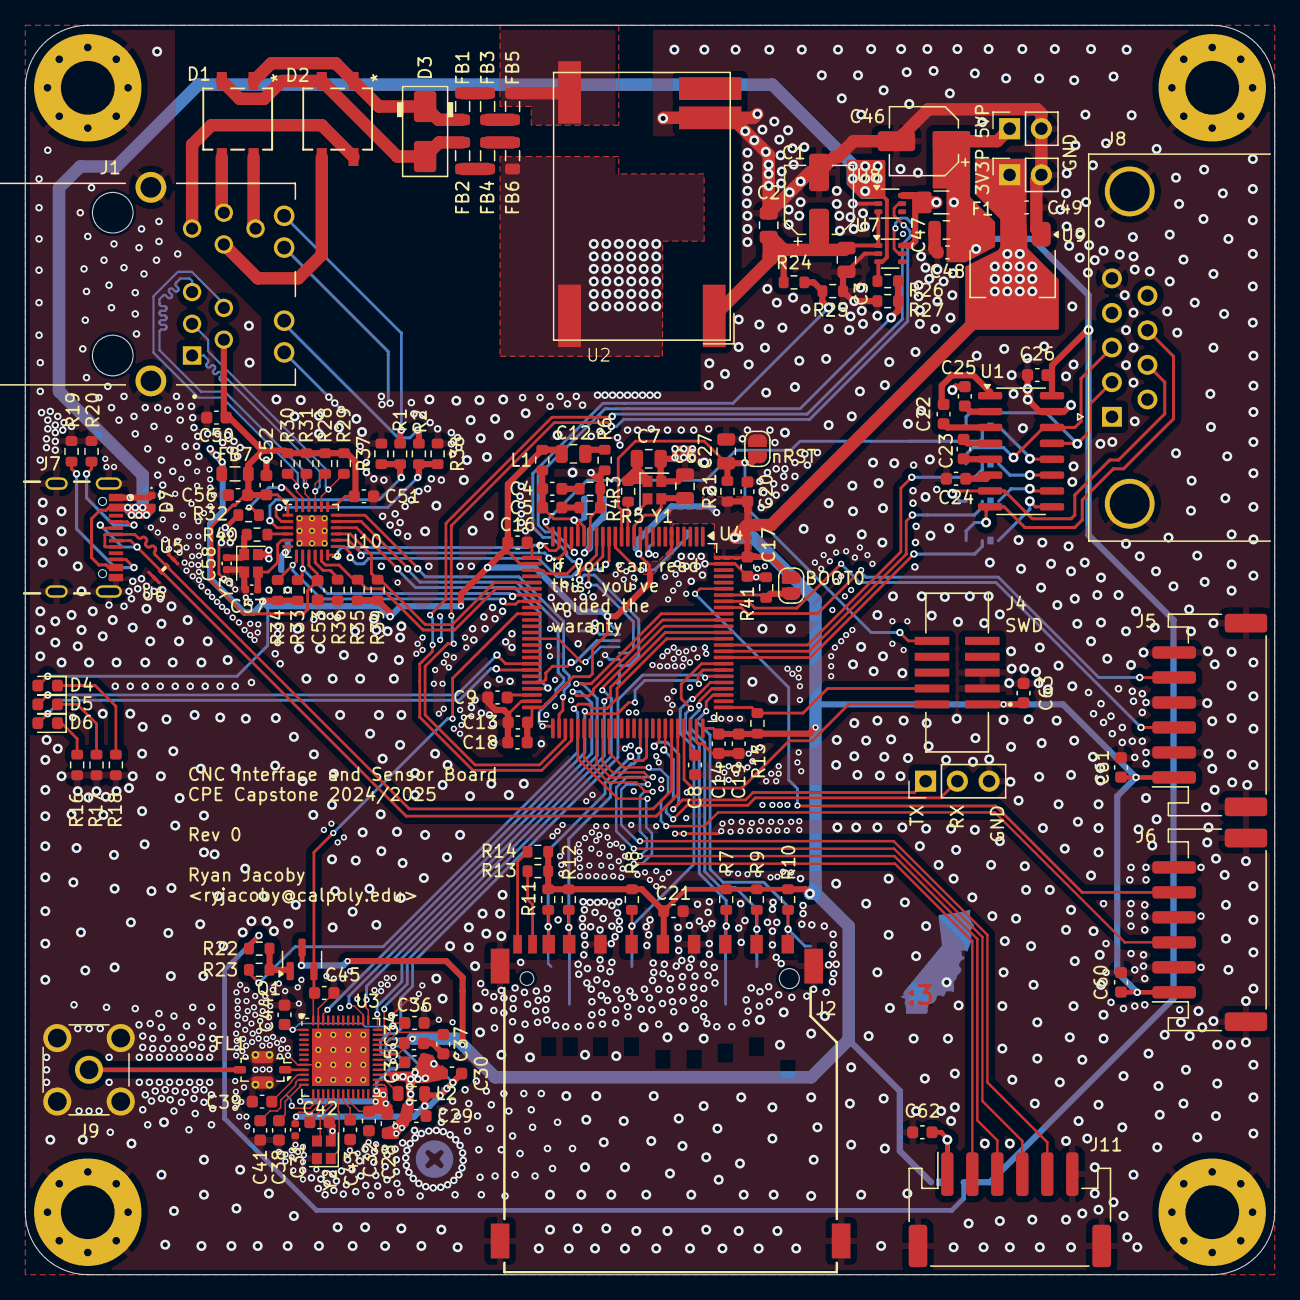
[picture p43: board hw_alpha.kicad_pcb from above]

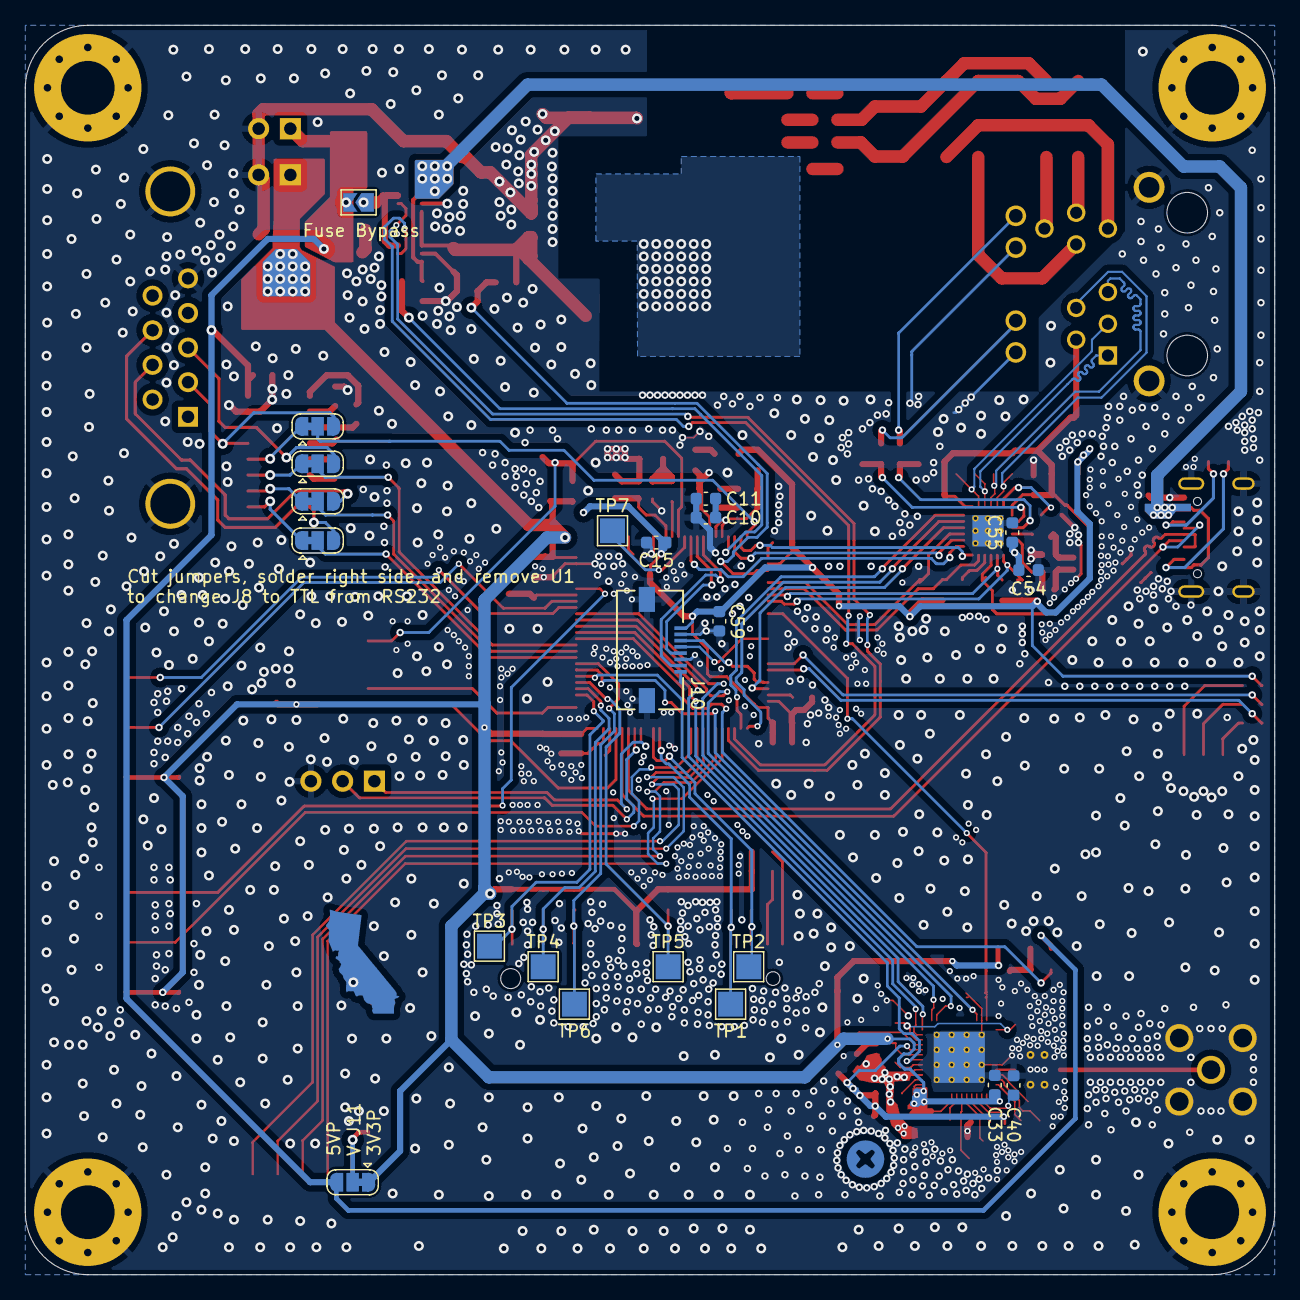
[picture p44: board hw_alpha.kicad_pcb from below]

Board: 4 copper layers, 100.0 x 100.0 mm, 168 parts (22 on the bottom side), 135 nets.
