Yexall/CPE-450.Capstone/Hardware/IIS3DWB_eval/IIS3DWB_eval.kicad_pcb

## KiCad design Hardware/IIS3DWB_eval/IIS3DWB_eval.kicad_pcb (2025-03-19)

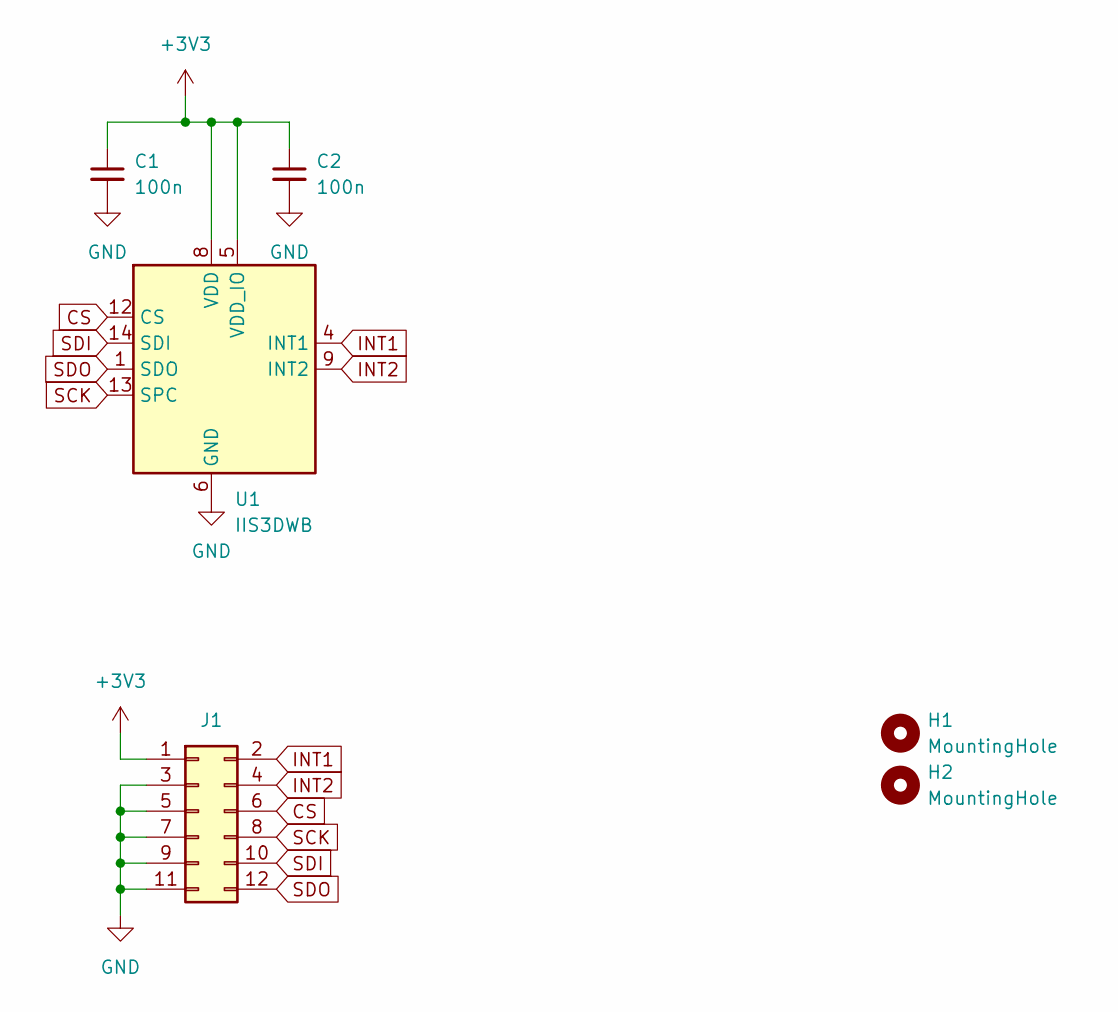
[picture p45: schematic IIS3DWB_eval.kicad_sch, IIS3DWB Eval board]

Parts:
C1, C2: 100n; C_0805_2012Metric
H1, H2: MountingHole; MountingHole_2.7mm_M2.5
J1: 2.45mm Pin header; PinHeader_2x06_P2.54mm_Vertical
U1: IIS3DWB; LGA-14_3x2.5mm_P0.5mm_LayoutBorder3x4y; MPN IIS3DWBTR

Connections:
+3V3: C1.1, C2.1, J1.1, U1.5 (VDD_IO), U1.8 (VDD)
CS: J1.6, U1.12 (CS)
GND: C1.2, C2.2, J1.3, J1.5, J1.7, J1.9, J1.11, U1.2 (GND), U1.3 (GND), U1.6 (GND), U1.7 (GND)
INT1: J1.2, U1.4 (INT1)
INT2: J1.4, U1.9 (INT2)
SCK: J1.8, U1.13 (SPC)
SDI: J1.10, U1.14 (SDI)
SDO: J1.12, U1.1 (SDO)

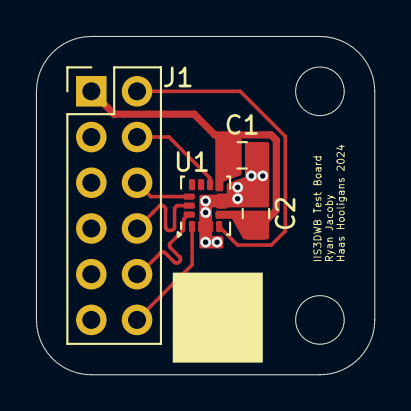
[picture p46: board IIS3DWB_eval.kicad_pcb from above]

Board: 2 copper layers, 18.8 x 18.8 mm, 6 parts (0 on the bottom side), 8 nets.
