Yexall/CPE-450.Capstone/(commit log)

2025-03-19 HW initial commit
    [3220-10-0300-00.step, 5051100892.stp, HDS_DIO.step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]
2025-03-24 Add hardware license and fix BOM issues
    [IIS3DWB_breakout_beta.kicad_pcb, IIS3DWB_breakout_beta.kicad_sch, connectors.kicad_sch, digkey_bom.csv, hw_alpha.kicad_pcb, hw_alpha.kicad_sch]
